MashedPotato817/CargoTracker-STM32H7/pic/5 loT系统前后端交互架构图.png

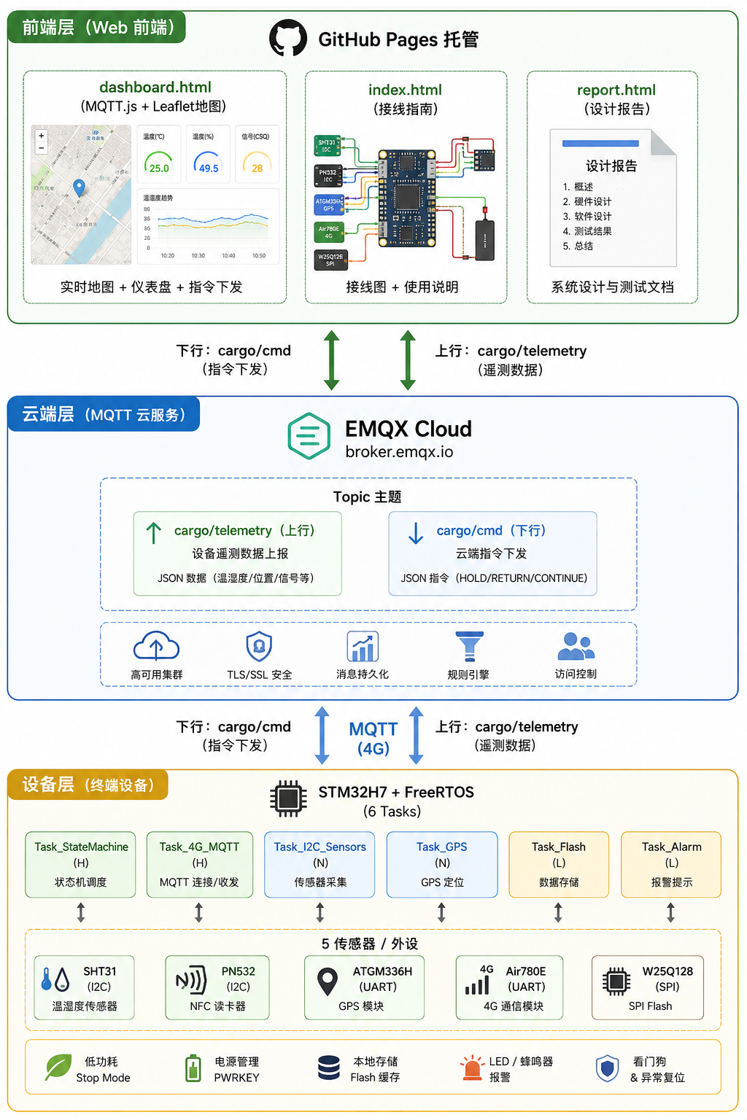
pic/5 loT系统前后端交互架构图.png
