MashedPotato817/CargoTracker-STM32H7/pic/硬件总览图.png

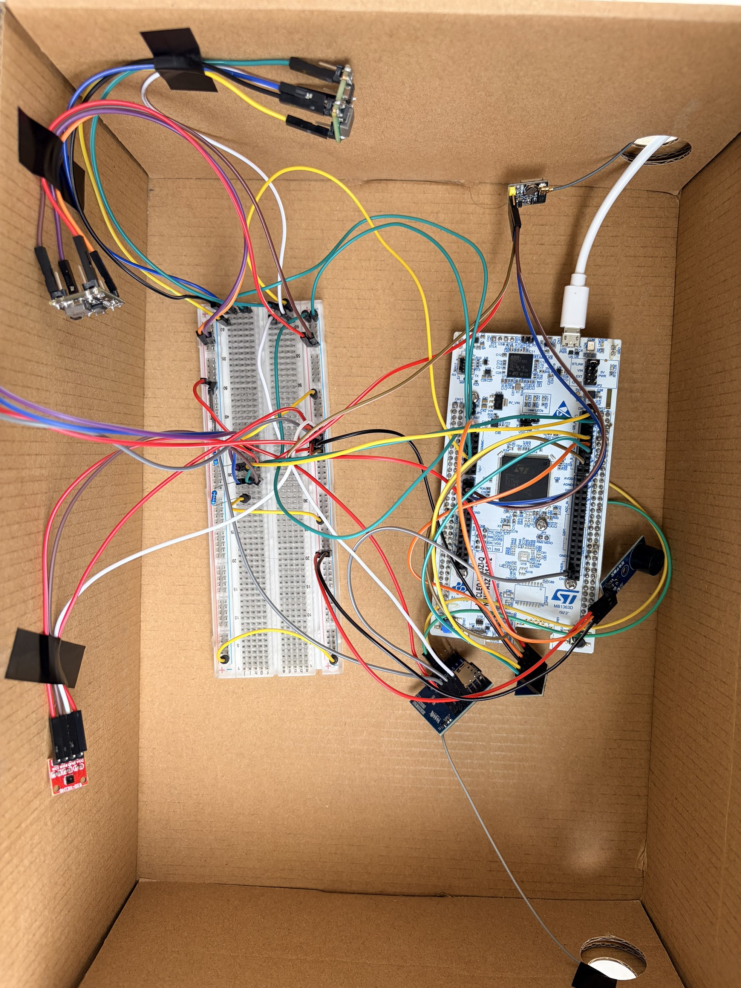
pic/硬件总览图.png
