MashedPotato817/CargoTracker-STM32H7/report-workflow/video-script.md

# 演示视频解说文案

> 匿名要求：不出现学校名称、logo、校徽、导师信息
> 时长：严格控制在 3 分钟内

---

## 分段文案

### 片头（0:00-0:02）
> 大赛统一封面，不添加任何字幕或文字

---

### 第 1 段：作品介绍（0:02-0:18）

| 画面 | 字幕 | 配音 |
|---|---|---|
| 整机接线正面特写 → 45° 斜拍全景，所有模块清晰可见 | 基于 STM32H7 的智能货物追踪物联网系统 | 本作品是一款基于 STM32H7 的智能货物追踪设备，集成了 GPS 定位、NFC 激活、温湿度监测、4G 云端通信和低功耗管理。 |

---

### 第 2 段：NFC 激活演示（0:18-0:38）

| 画面 | 字幕 | 配音 |
|---|---|---|
| 设备处于休眠状态，黄色 LED 慢闪 → NFC 标签靠近 PN532 → LED 状态变化 → 设备被唤醒 | NFC 无源激活 | 设备上电后默认处于深度睡眠模式。使用 NTAG215 NFC 标签靠近 PN532 读卡模块，设备被瞬间唤醒，进入工作循环。 |
| 串口打印 `[NFC] activation event` | 串口实时输出 | 整个过程无需物理按键，实现无源、无接触激活。 |

---

### 第 3 段：GPS 定位（0:38-1:05）

| 画面 | 字幕 | 配音 |
|---|---|---|
| 画中画——主画面：GPS 模块特写（蓝色 LED 闪烁） / 小窗：dashboard 地图 marker 从默认华东视角飞行到设备位置 | GPS 实时定位 | 设备唤醒后，ATGM336H GPS 模块开始搜星定位。通过 USART2 接收 NMEA 语句，解析 RMC 和 GGA 帧，提取 WGS-84 经纬度坐标。 |
| dashboard 地图 zoom in 到设备位置，经纬度数字显示 | 坐标实时上报 | 定位数据通过 4G 网络上传至云端，配套 Web 控制台使用 Leaflet 地图实时标记设备位置。 |

---

### 第 4 段：温湿度监测（1:05-1:30）

| 画面 | 字幕 | 配音 |
|---|---|---|
| SHT31 传感器特写 → 手指靠近传感器 | SHT31 温湿度采集 | SHT31 高精度温湿度传感器，通过 I2C 总线读取数据，含 CRC8 校验确保数据完整性。 |
| 串口输出温度从 25°C 升至 27°C → dashboard 仪表盘温度数字同步上升 | 温度 25°C → 27°C | 手指靠近传感器，温度即刻响应。采样采用请求-响应模式，状态机置位采样标志，传感器任务仅在需要时读取，避免周期性无效采样，降低系统功耗。 |

---

### 第 5 段：4G 上报 + 云端控制台（1:30-2:00）

| 画面 | 字幕 | 配音 |
|---|---|---|
| Air780E 4G 模块特写（天线+指示灯）→ dashboard 仪表盘全貌（温湿度仪表+地图+信号强度+数据日志） | 4G MQTT 云端上报 | Air780E 4G 模块通过 AT 指令建立 TCP 连接，使用自研二进制 MQTT 协议栈完成 CONNECT、PUBLISH、SUBSCRIBE 帧构建。 |
| dashboard 数据日志滚动，显示 JSON 数据 | 每 10 秒上报一次 | 温湿度、GPS 坐标、4G 信号强度封装为 JSON，每 10 秒通过 MQTT 发布至 EMQX Broker，配套自建 Web 控制台实时接收并可视化展示。 |
| 手机端打开 dashboard，展示移动端适配效果 | 手机扫码即可查看 | 控制台为单文件 HTML，托管于 GitHub Pages，手机扫码即可实时查看货物状态。 |

---

### 第 6 段：云端指令（2:00-2:25）

| 画面 | 字幕 | 配音 |
|---|---|---|
| 画中画——主画面：dashboard 点击「暂留」按钮 / 小窗：设备 LED 变化（黄色常亮） | 云端指令：暂留 | 云端控制台支持三指令下发——暂留、退货、继续运输。点击「暂留」，设备收到指令后黄色 LED 常亮，保持唤醒等待后续指令。 |
| 点击「退货」→ 蜂鸣器鸣叫 + LED 快闪 | 退货：触发报警 | 点击「退货」，设备触发声光报警——蜂鸣器鸣叫，LED 快闪。 |
| 点击「继续运输」→ 恢复正常心跳闪烁 | 继续运输：恢复正常 | 点击「继续运输」，清除报警状态，LED 恢复心跳闪烁，货物继续运输。 |

---

### 第 7 段：低功耗休眠（2:25-2:45）

| 画面 | 字幕 | 配音 |
|---|---|---|
| 指令执行完毕后 → 串口打印进入 Stop Mode → 设备静默 | 低功耗 Stop Mode | 任务完成后，设备通过 PWRKEY 关闭 4G 模块，MCU 进入 STOP 低功耗模式，电流降至微安级。 |
| NFC 标签再次靠近 → 设备再次唤醒 | NFC 再次唤醒 | 再次使用 NFC 标签靠近，设备被重新唤醒，进入下一个工作循环。实现全流程自动化闭环。 |

---

### 第 8 段：全链路回顾（2:45-2:55）

| 画面 | 字幕 | 配音 |
|---|---|---|
| 快速混剪：NFC 刷卡 → GPS 坐标更新 → 温度变化 → dashboard 仪表盘刷新 → 指令下发 → LED 响应 → 休眠 | NFC → GPS → SHT31 → MQTT → 云指令 → 休眠 | 从 NFC 激活到云端指令响应，整条链路全自动化——无接触唤醒，实时定位，环境监测，4G 上报，远程控制，智能休眠。 |

---

### 结尾（2:55-3:00）

| 画面 | 字幕 |
|---|---|
| 黑底白字 | 谢谢观看 |

> 结尾不出现学校名称、队名、队员姓名。

---

## 注意事项

- 所有字幕和配音**不包含学校名称/logo/校徽/导师信息**
- GPS 定位等待片段可 1.5x 加速，但不能跳过
- 蜂鸣器报警声**务必录进去**——证明硬件真正在工作
- 串口输出画面保留 1-2 秒以便评委看清
- 双画面画中画用于第 3 段（GPS+地图）和第 6 段（指令+LED），强调软硬件协同
