MashedPotato817/CargoTracker-STM32H7/doc-workflow/last-tasks.md

# 未完成任务清单

> 截止：**2026-07-09 18:00** | 由 task2/3/4/5 + code-review 汇总生成
>
> 状态：✅ 完成 ⚠️ 部分完成/阻塞 ❌ 未开始

---

## 一、硬件验证（task2 遗留）

| # | 任务 | 负责人 | 状态 | 阻塞原因 |
|:---:|---|:---:|:---:|---|
| 2.2 | PN532 NFC 标签读取验证 | A | ⚠️ | init OK，未测试实际标签 |
| 2.3 | GPS 户外真坐标测试 | B | ⚠️ | 当前 stub 31/121，需户外 |
| 2.4 | W25Q128 读写验证 | A | ⚠️ | JEDEC OK，读写未测 |
| 2.7 | 系统集成测试（9 项） | C | ❌ | 依赖 2.2-2.6 全部完成 |

---

## 二、云端功能（task3 遗留）

| # | 任务 | 负责人 | 状态 | 说明 |
|:---:|---|:---:|:---:|---|
| 3.3 | 云指令端到端验证 | B+C | ⚠️ | 代码已就绪，待硬件联调 |
| 3.4 | 断网缓存补传 | B | ❌ | 依赖 W25Q128 读写验证 + code-review #5,#6 |

### code-review 阻塞项（影响 3.4）

| 编号 | 问题 | 负责人 |
|:---:|---|:---:|
| #5 | W25Q128 重启擦除扇区 — 缓存数据不可逆销毁 | A |
| #6 | W25Q128 读取/上传路径完全缺失 | A |

> 修复后 3.4 才能推进。

---

## 三、低功耗优化（task4 全部）

| # | 任务 | 负责人 | 状态 | 预计 |
|:---:|---|:---:|:---:|:---:|
| 4.1 | Stop Mode 实现（替换 stub） | C | ❌ | 1h |
| 4.2 | 功耗测量（全速 + Stop） | C | ❌ | 0.5h |
| 4.3 | 4G 空闲断电 | C | ❌ | 1h |
| 4.4 | 电池续航估算 | C | ❌ | 0.5h |

> code-review #6 正是 Stop Mode stub 问题，已确认是全速空转。论文需要本章数据。

---

## 四、产出物（task5）

| # | 产出 | 负责人 | 状态 | 说明 |
|:---:|---|:---:|:---:|---|
| 5.3 | 报告 PDF | C | ⚠️ | 内容已有，缺实物照片 + 打印样式 |
| 5.4 | 演示视频 MP4 | 全员 | ❌ | 需硬件跑通后拍摄 |
| 5.5 | 代码 RAR | C | ❌ | 0.5h，最后打包 |

---

## 五、code-review P0/P1 未修复项

| 优先级 | 编号 | 问题 | 负责人 | 状态 |
|:---:|:---:|---|:---:|:---:|
| P0 | #1,#2 | USART1 互斥锁 + DMA/中断接收 | B | ❌ |
| P0 | #3 | TCP_SendBinary 验证 SEND OK | B | ✅ 已修 |
| P0 | #4 | CONNACK 返回码检查 | B | ❌ |
| P0 | - | CSQ 加入 telemetry | B | ✅ 已修 (16d426d) |
| P1 | #5,#6 | W25Q128 重启不擦除 + 补上传路径 | A | ❌ |
| P1 | #7 | printf 加互斥锁 | C | ❌ |
| P1 | #8 | HAL_Delay → osDelay 全局替换（5 处） | A/B/C | ❌ |

---

## 六、按负责人的行动清单

### A（驱动层）
- [ ] PN532 标签读取测试（2.2）
- [ ] W25Q128 读写验证（2.4）
- [ ] **W25Q128 重启不擦除 + 补读取/上传路径**（review #5,#6）
- [ ] PN532 DCS 校验 + 缓冲区越界修复（review #10,#11）
- [ ] W25Q128 WEL 校验（review #12）
- [ ] sht31/pn532 HAL_Delay → osDelay（review #8）

### B（通信层）
- [x] **CSQ 加入 telemetry** ✅ (16d426d)
- [x] PDP 激活 + 上报周期优化 ✅ (16d426d)
- [ ] GPS 户外真坐标测试（2.3）
- [ ] **USART1 DMA/中断接收 + 互斥锁**（review #1,#2）— 最重要
- [ ] CONNACK 返回码检查（review #4）
- [ ] MQTT 命令误触发修复（review #15）
- [ ] GPS 空字段校验 + strtok_r + 精度（review #13,#14,#18）
- [ ] AT 命令重试 + 掉线恢复（review #17,#19）
- [ ] mqtt HAL_Delay → osDelay（review #8）

### C（应用层 + 前端 + 文档）

**✅ 已完成：**
- [x] dashboard 自动重连 + 地图定位 + 移动端修复
- [x] 三页面统一 footer 跳转
- [x] 代码全面审查报告 (29 问题)
- [x] task5 产出物对齐 demand.md
- [x] doc-workflow 目录整理

**❌ C 代码阻塞（队友在改，不碰）：**
- [ ] printf 互斥锁、HAL_Delay→osDelay、Stop Mode、死代码

**📋 可做：**
- [ ] 报告 print 样式 → 导出 PDF（task 5.3）— 缺实物照片
- [ ] 代码 RAR 打包（task 5.5）
- [ ] 视频（task 5.4）— 等硬件

---

## 七、建议执行顺序

```
1. C: printf 互斥锁 (15min)                   ← 快速修复，所有人受益
2. C: power.c HAL_Delay → osDelay (10min)      ← 解除 6.5s 阻塞
3. B: USART1 DMA/中断 + 互斥锁 (3-4h)          ← 最关键通信修复
4. A: W25Q128 修复 (3-4h)                       ← 断网缓存能真正工作
5. A+B: 各自 HAL_Delay → osDelay                ← 5 处全局替换
6. C: Stop Mode 实现 (1h)                       ← 论文数据 + 低功耗
7. C: 功耗测量 (0.5h)                            ← 论文必须
8. 全员: 系统联调 + 视频拍摄                     ← 产出物
9. C: 报告导出 + 代码打包                        ← 提交
```

---

> 参考：`doc/code-review-20260709.md` | 生成时间：2026-07-09
