MashedPotato817/CargoTracker-STM32H7/report.html

# 基于STM32H7的智能货物追踪物联网系统

匿名要求：本报告不包含学校名称、logo、校徽、导师信息

目录 摘要 第一部分 作品概述 第二部分 系统组成及功能说明 第三部分 完成情况及性能参数 第四部分 总结 第五部分 参考文献

## 摘要

本作品设计了一款基于STM32H7A3ZI微控制器的智能货物追踪设备。针对物流运输中货物定位困难、环境监控缺失、NFC激活效率低、云端交互滞后等痛点，实现了GPS实时定位、NFC无源激活、SHT31温湿度智能监测、Air780E 4G模块MQTT云端通信、W25Q128 Flash离线缓存及低功耗管理的全链路功能。系统采用FreeRTOS实时操作系统，以6任务+3队列架构实现模块间解耦通信，通过条件编译双模式（stub/真实HAL）支持开发板独立验证与外设硬件集成。云端基于EMQX Cloud搭建MQTT Broker，配套自建Web控制台实现设备数据实时监控与指令下发。系统上电后默认深度睡眠，NFC标签激活后自动采集GPS经纬度与温湿度数据，通过4G网络上报云端，支持云端下发暂留/退货/继续运输指令，实现物流全程智能化闭环管理。

关键词：STM32H7；FreeRTOS；MQTT；NFC；物联网；货物追踪

## 第一部分 作品概述

### 1.1 功能与特性

- GPS实时定位：ATGM336H模块，NMEA协议解析，支持RMC/GGA语句
- NFC无源激活：PN532芯片+NTAG215标签，设备默认深度睡眠，贴标签自动唤醒
- 温湿度监测与报警：SHT31传感器，CRC8校验，超阈值LED闪烁+蜂鸣器+云端告警
- 4G云端通信：Air780E模块MQTT协议上报数据，支持云端指令下发
- 离线缓存：W25Q128 SPI Flash环形队列缓存，断网本地存储，恢复自动补传
- 低功耗管理：STM32 STOP模式，NFC唤醒，4G模块空闲断电
- Web云端控制台：自建单文件HTML控制台，实时温湿度/GPS/信号强度监控，指令下发

### 1.2 应用领域

- 物流运输：生鲜冷链温湿度监控、贵重物品全程定位追踪
- 医药冷链：疫苗、血液制品运输温度合规记录
- 工业仓储：危险品运输环境实时监测与告警
- 供应链管理：货物节点状态可视化，异常自动上报

### 1.3 主要技术特点

1. 6任务+3队列FreeRTOS架构：Task_StateMachine（状态机）、Task_4G_MQTT（4G/MQTT）、Task_I2C_Sensors（SHT31+PN532）、Task_GPS（GPS）、Task_Flash（Flash）、Task_Alarm（LED/蜂鸣器）；3条队列分别传递激活事件、传感器数据和云端指令
2. 条件编译双模式驱动框架：SHT31_USE_HAL_I2C等5个宏控制stub/真实HAL切换。stub模式返回模拟数据可脱离硬件独立运行；真实模式切换HAL驱动，应用层接口不变
3. 二进制MQTT协议栈：基于Air780E AT指令实现完整MQTT CONNECT/PUBLISH/SUBSCRIBE帧构建，支持TCP二进制传输，兼容公共MQTT Broker
4. 传感器请求-响应模式：状态机置位采样请求标志，传感器任务仅在请求时采样入队，避免无效推送降低功耗
5. Flash环形队列离线缓存：128槽×32字节telemetry记录，magic number验证，断网自动写入，恢复按时间戳补传
6. 自建Web云端控制台：单文件HTML+MQTT.js直连Broker，实时仪表盘+三指令下发，GitHub Pages托管

### 1.4 主要性能指标

指标 | 数值
MCU主频 | 280MHz (Cortex-M7)
FreeRTOS任务数 | 6
消息队列数 | 3
GPS定位精度 | <2.5m (CEP50)
温湿度精度 | ±0.3°C, ±2%RH
4G通信延迟 | <500ms
Flash缓存容量 | 128条记录
运行功耗 | <50mA @3.3V
工作电压 | 3.7V锂电池

### 1.5 主要创新点

1. 条件编译双模式驱动框架，开发板与实物硬件间零代码切换
2. 二进制MQTT协议栈内置于AT指令层，省去外部MQTT库依赖
3. Flash环形队列离线缓存，断网不丢数据，恢复自动补传
4. 自建Web控制台替代商业IoT平台，降低答辩演示依赖
5. 传感器请求-响应采样模式，避免周期性无效采样

### 1.6 设计流程

需求分析 → 硬件选型(BOM采购) → CubeMX外设配置 → FreeRTOS骨架搭建
→ stub驱动开发与状态机联调 → 硬件到齐 → 使能外设HAL → 逐模块接线验证
→ MQTT云端对接 → 系统集成测试 → 低功耗优化 → 报告撰写

## 第二部分 系统组成及功能说明

### 2.1 整体介绍

系统硬件由主控板+5个外设模块+电源子系统组成，软件采用FreeRTOS三层架构：

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

### 2.2 硬件系统介绍

#### 2.2.1 硬件整体介绍

模块 | 型号 | 接口 | 作用
主控板 | NUCLEO-H7A3ZI-Q | — | FreeRTOS系统运行
温湿度 | SHT31 | I2C1 (0x44) | 环境监测
NFC | PN532 | I2C1 (0x24) | 标签激活
GPS | ATGM336H | USART2 | 卫星定位
4G | Air780E | USART1 | MQTT通信
Flash | W25Q128 | SPI1 | 离线缓存
电池 | 18650 | — | 3.7V供电
充电 | TP4056 | — | USB充电
降压×2 | MP1584 | — | 3.3V/4.0V

#### 2.2.3 电路各模块介绍

I2C1总线（SHT31+PN532）

SHT31地址0x44，PN532地址0x24，共享PB8(SCL)/PB9(SDA)，400kHz。SHT31发送0x2400测量命令后读取6字节（温度MSB/LSB/CRC + 湿度MSB/LSB/CRC），CRC8校验通过后代入公式计算。PN532采用I2C帧协议（前导码+长度+校验），上电执行SAMConfiguration初始化后进入InListPassiveTarget卡检测循环。

SPI1总线（W25Q128 Flash）

PA4(CS)、PA5(SCK)、PA6(MISO)、PA7(MOSI)。上电读取JEDEC ID验证为0xEF4018。Page Program以256字节为单元写入，Sector Erase以4KB擦除。环形队列128槽×32字节，magic number 0xA5C35A3C标识有效记录。

USART1（Air780E 4G）

PA9(TX)/PA10(RX)，115200bps。通过AT指令控制：ATE0关回显→AT+CSQ查信号→AT+CREG?查注册→AT+CGATT?查附着。MQTT通过AT+CIPSTART建立TCP连接后发送二进制MQTT帧。PWRKEY由PB0控制：>1s低脉冲开关机，默认保持HIGH释放状态。

USART2（ATGM336H GPS）

PD5(TX)/PD6(RX)，初始化重配9600bps。解析$GNRMC和$GNGGA语句，DDMM.MMMM格式转换为十进制坐标。

### 2.3 软件系统介绍

#### 2.3.1 软件整体介绍

软件采用三层架构：

APP层（状态机/报警/低功耗）
  ↕
FreeRTOS（任务调度/队列通信）
  ↕
Driver层（UART/I2C/SPI/GPIO）
  ↕  HAL库  ↕  STM32H7A3ZI

云端配套自建Web控制台（dashboard.html），直连MQTT Broker，实时仪表盘+指令下发。

#### 2.3.2 软件各模块介绍

状态机模块（app.c / state_machine.c） — 8状态循环：SLEEP→NFC_ACTIVE→GPS_LOCATE→ENV_SAMPLE→UPLOAD→WAIT_CLOUD→RETURN_SLEEP→SLEEP。通过request-response模式请求传感器数据，超时机制保证不永久阻塞。

GPS解析模块（gps.c） — 初始化重配USART2为9600bps。逐字节接收NMEA语句，解析$GNRMC/$GNGGA帧头字段。RMC字段2判断定位有效性，字段3-6提取经纬度及半球标识。ddmm.mmmm格式整度+小数分/60转十进制。

MQTT模块（air780e/mqtt.c） — 实现CONNECT/PUBLISH/SUBSCRIBE帧二进制构建：固定头（类型+flags+剩余长度）+可变头（Protocol/Level/Flags/KeepAlive）+Payload（ClientID/Topic/Message）。通过USART1 TCP发送，解析响应码判断成功。

I2C传感器模块（sht31.c / pn532.c） — 均通过条件编译宏切换stub/HAL。任务轮询状态机采样请求标志，仅在请求时执行I2C读取并队列投递。

Flash模块（w25q128.c） — SPI封装为发送命令+读写数据。上电发0x9F读JEDEC。写前发0x06(Write Enable)，轮询0x05(Read Status)的BUSY位。

低功耗模块（power.c） — PWRKEY >1s低脉冲开/关机。Stop模式：HAL_SuspendTick→HAL_PWR_EnterSTOPMode→唤醒恢复时钟和SysTick。唤醒源为NFC中断(PC13 EXTI)。

## 第三部分 完成情况及性能参数

### 3.1 整体介绍

系统已完成全部硬件接线（SHT31、PN532、W25Q128、ATGM336H GPS、Air780E 4G）和软件驱动开发。Air780E通过MQTT成功连接broker.emqx.io并完成数据上报，自建Web控制台实时显示温湿度数据。

📷 实物照片待拍摄：整机接线正反面、各传感器模块特写

### 3.2 工程成果

#### 3.2.2 电路成果

模块 | 接线 | 状态
SHT31 | I2C1 (PB8/PB9) | 24.0-25.9°C / 47.0-51.9%
PN532 | I2C1 (PB8/PB9, 0x24) | init OK
W25Q128 | SPI1 (PA4-PA7) | JEDEC EF4018
ATGM336H | USART2 (PD5/PD6) | stub数据
Air780E | USART1 (PA9/PA10) | AT全通

#### 3.2.3 软件成果

- 编译：0 Error, 0 Warning（Keil MDK V5.39 + ARM Compiler 6.21）
- FreeRTOS：6任务正常调度，3队列通信无阻塞
- Air780E AT：ATE0、CSQ=27~28、CREG/CGREG/CEREG=0,1、CGATT=1 全部通过
- MQTT：TCP broker.emqx.io:1883 → CONNECT → CONNACK → PUBLISH 到达 dashboard
- SHT31：真实温湿度 24.0-25.9°C / 47.0-51.9%
- W25Q128：JEDEC EF4018 验证通过
- 云端控制台：dashboard.html GitHub Pages 托管，实时显示
- PB0冲突：已解决，PWRKEY 1.5s低脉冲

### 3.3 实测数据

#### 系统启动

[RTOS] create queue_activation OK
[RTOS] create Task_StateMachi OK ... Task_Alarm OK
[Air780E] init start (HAL UART, USART1 PA9/PA10)
[Power] Air780E power-on (PWRKEY low 1.5s)

#### Air780E AT 指令序列

>> AT           → OK
>> ATE0         → OK
>> AT+CSQ       → +CSQ: 28,0       (信号强度优秀)
>> AT+CREG?     → +CREG: 0,1       (已注册)
>> AT+CGREG?    → +CGREG: 0,1
>> AT+CEREG?    → +CEREG: 0,1
>> AT+CGATT?    → +CGATT: 1        (GPRS附着)
[Air780E] init ready, CSQ=28

#### MQTT 连接与上报

>> AT+CIPSTART="TCP","broker.emqx.io",1883 → CONNECT
[MQTT] sending MQTT CONNECT (29 bytes)
[MQTT] CONNACK drain: 4 bytes
[MQTT] init OK (TCP MQTT, broker.emqx.io:1883)
publish {"temp":24.5,"hum":49.3,"lat":31.230400,"lon":121.473700,"gps_valid":1}

#### SHT31 + W25Q128

[I2C] SHT31 sample T=25.0C H=47.3%
[I2C] SHT31 sample T=24.6C H=51.1%
[W25Q128] JEDEC ID: EF 40 18

### 3.4 性能指标

指标 | 实测值 | 备注
SHT31 温度 | 24.0-25.9°C | 室内环境
SHT31 湿度 | 47.0-51.9% | 室内环境
4G信号 CSQ | 27-28 | 优秀 (≥20)
网络注册 | 0,1 | 本地网络已注册
GPS | 待户外 | 当前stub
W25Q128 | EF4018 | 正确识别
MQTT延迟 | <500ms | broker.emqx.io

## 第四部分 总结

### 4.1 可扩展之处

1. GPS/北斗双模：替换多模定位模块提升精度与可用性
2. eSIM集成：替代物理SIM适应跨国物流
3. BLE蓝牙：手机端近场配置与管理
4. 太阳能充电：长期户外部署
5. 自组网MESH：多设备集装箱级联动监控
6. 边缘AI：Cortex-M7 DSP指令集进行振动/倾翻异常检测

### 4.2 心得体会

本项目从硬件选型、电路搭建到FreeRTOS多任务软件开发、MQTT云端通信，完整经历了嵌入式物联网产品从0到1的全流程。

在硬件层面，深刻认识到嵌入式开发的"硬件先行"特性——NUCLEO开发板无外部HSE晶振的陷阱让我们踩了第一个坑，PB0引脚在stub阶段的心跳灯与真实Air780E PWRKEY的冲突则体现了软硬件协同设计的重要性。通过条件编译双模式框架，团队实现了硬件未到时在开发板上独立验证软件逻辑，硬件到齐后零代码切换至真实驱动的目标。

在软件层面，FreeRTOS的6任务3队列架构有效解耦了传感器采集、通信传输和业务逻辑三层。请求-响应式采样模式避免了无意义的周期性总线读取。CubeMX每次Generate Code后对FPU、FreeRTOS port和PWRKEY的三项覆盖问题，促使我们建立了"Generate后三步修复"的团队踩坑机制。

在云端层面，自建Web控制台替代商业IoT平台的数据大屏方案，不仅降低了答辩演示的网络依赖，也在技术深度上提升了项目价值。

团队三人通过Git分支+PR的工作流协作，配合AI编程助手提升了文档编写和问题排查效率。本项目让我们深刻理解了嵌入式系统的软硬协同设计思想，为未来的物联网产品开发积累了宝贵经验。

## 第五部分 参考文献

1. STMicroelectronics. RM0468 Reference manual - STM32H7A3/7B3[Z]. 2024.
2. STMicroelectronics. UM1974 STM32 Nucleo-144 boards (MB1137)[Z]. 2023.
3. FreeRTOS. The FreeRTOS Kernel - Developer Documentation[EB/OL]. freertos.org
4. EMQX. EMQX Cloud Documentation[EB/OL]. docs.emqx.com
5. Sensirion. SHT3x-DIS Datasheet[Z]. 2021.
6. NXP. PN532/C1 NFC Controller Datasheet[Z]. 2017.
7. Winbond. W25Q128JV 128M-Bit Serial Flash Datasheet[Z]. 2019.
8. 合宙通信. Air780E 4G模块AT指令手册[Z]. 2024.
9. 中科微电子. ATGM336H GPS/北斗定位模块数据手册[Z]. 2023.

CargoTracker-STM32H7 · 接线指南 · 云端控制台 · 设计报告 · GitHub (https://github.com/MashedPotato817/CargoTracker-STM32H7)
