MashedPotato817/CargoTracker-STM32H7/report-workflow/suggest.md

在嵌入式与电子设计类竞赛（如**全国大学生电子设计竞赛（国奖/电赛）**、**中国研究生创芯大赛**、**蓝桥杯嵌入式**、**大创**等）中，一份优秀的**作品设计报告**是决定能否拿奖（尤其是国奖答辩资格）的关键。

这类报告与普通的期末大作业或纯软件开发文档不同，它极其注重**软硬件结合的系统性、测试数据的严密性以及格式的规范性**。以下为你整理的嵌入式比赛报告核心要求与标准结构：

---

## 一、 严苛的“高压线”与基本格式要求

在准备报告前，必须绝对遵守以下规范，否则可能直接面临**一票否决（取消评审资格）**：

* **匿名原则（盲审）**：正文、图表、页眉页脚、甚至是代码片段中，**绝对不能出现**学校名称、队伍编号、队员及指导老师姓名。
* **字数与篇幅限制**：以电赛（NUEDC）为例，正文长度通常严格限制在 **A4纸 8 页以内**（含图表，不含附录代码），首页通常要求附 **300字以内的中文摘要**。
* **排版规范**：通常要求正文小四号宋体/新罗马字体，固定行距（如22磅），且上方要留出足够的空白（通常为3cm以上）用于赛区统一装订和密封。

---

## 二、 报告的标准结构与核心内容

一份标准的嵌入式比赛报告，通常由以下六大核心板块构成：

### 1. 摘要与关键词（Abstract）

* **内容**：用精炼的语言说清：**“本系统实现了什么功能 + 采用了什么核心芯片/算法 + 达到了什么指标”**。
* **要点**：摘要中必须包含**具体的量化测试结果**（例如：“纹波效率达到95%”、“响应时间小于10ms”），切忌假大空。

### 2. 系统方案论证（最体现水平的板块）

评委非常看重你为什么选择这个方案，而不是那个方案。需要对关键模块进行**对比论证**：

* **主控芯片选择**：例如，为什么用 STM32 还是 FPGA？（从算力、外设、功耗、成本等维度对比，可用表格呈现）。
* **传感器/驱动模块选择**：对比不同型号传感器的精度、通信接口（I2C/SPI/串口）。
* **软件架构/算法论证**：是采用裸机状态机，还是 FreeRTOS 实时操作系统？PID控制还是模糊控制？

### 3. 硬件电路设计（图表要清晰）

* **系统整体框图**：给出清晰的硬件架构拓扑图，明确电源流向和信号流向。
* **核心模块电路**：
* **电源模块**：嵌入式系统的基石（如 5V 转 3.3V，LDO 还是 DC-DC 降压）。
* **信号调理/驱动电路**：如放大电路、光耦隔离、电机驱动（H桥）电路。
* **注意**：报告中放入的原理图切忌直接从 Altium Designer 里截个大模糊图，应转成清晰的矢量图或单色精简原理图，并对关键元件参数（如滤波电容、上拉电阻）做简要计算说明。

### 4. 软件设计与算法实现（体现逻辑）

* **程序流程图**：必须包含**主程序流程图**和**核心中断/算法流程图**。
* **功能模块划分**：阐述各个任务（Task）的分配与优先级，如何进行低功耗管理或数据缓存。
* **核心算法描述**：如果涉及滤波算法（如卡尔曼滤波）、控制算法（如增量式PID）或路径规划，需给出数学公式和离散化实现思路。

### 5. 测试方案与测试结果（决定成败的硬指标）

评委往往最先翻到这一页看指标是否达标。

* **测试仪器**：列出测试使用的标准仪器（如：数字示波器、万用表、可编程电子负载）。
* **测试方法**：用图示或文字说清楚你怎么测的（例如：在哪里接的探头，如何模拟负载）。
* **测试数据（重中之重）**：
* 严禁只有一两组数据，必须有**多组测试数据表格**。
* 必须绘制**误差分析曲线或对比图表**。

* **结果分析**：根据数据得出结论，客观说明是否达到题目要求的发挥部分指标，若有误差，分析其产生原因（如线阻、ADC采样噪声等）。

### 6. 附录（Appendix）

* 主要放置**核心代码片段**（如初始化、核心控制算法，千万别把整个工程几千行代码全粘上去）。
* 部分比赛允许附上元器件清单（BOM表）。

---

## 三、 网上评委/学长推荐的拿奖加分项

1. **善用图表，拒绝大段文字**：能用表格对比的就不用文字，能用流程图、时序图、结构图解释的就不要写长篇大论。评委阅卷时间极短，**视觉可读性**决定第一印象。
2. **软硬件并重**：很多偏硬件的队伍软件写得很简陋，或者偏软件的队伍硬件电路全是买的模块。报告中如果能体现出**自己画的PCB Layout板图、3D效果图**，以及**软件架构的严密性**，会大大加分。
3. **理论计算与实际测试呼应**：在硬件设计里推导了某个滤波器的截止频率公式，在测试结果里最好能用示波器波形图来验证这个点。**理论 $\rightarrow$ 仿真 $\rightarrow$ 实测**的闭环是特等奖作品的标配。

你目前是在为某项具体的嵌入式比赛（如电赛、蓝桥杯、或某个大创项目）做准备吗？如果是，可以告诉我具体的比赛名称或选题方向，我可以为你提供更具针对性的排版模板或往届获奖报告的侧重点建议。
