MashedPotato817/CargoTracker-STM32H7/report-workflow/demand.md

# 附件1：全国大学生嵌入式芯片与系统设计竞赛
## 2026年应用赛道作品上传要求

作品上传要求如下：

### 1、作品介绍视频
-   **格式要求**：MP4格式
-   **时长限制**：总时长3分钟以内（其中大赛统一封面时长不超过2秒），请严格控制时间
-   **大小限制**：文件控制300M内
-   **内容提示**：切忌全部为ppt讲解过程，请把重点放在作品演示上

### 2、作品设计报告
-   **格式要求**：PDF格式
-   **大小限制**：50M以内

### 3、作品重要代码
-   **格式要求**：RAR压缩包
-   **大小限制**：100M以内

### 4、报名信息修改
-   作品名称及简介信息修改申请权限计划于2026年6月8日开放
-   所有报名信息（包括团队成员及作品信息）修改均于6月30日24时截止

### 5、作品上传截止
-   作品提交计划于2026年7月9日18时截止

### 6、匿名要求
-   作品报告及视频中均不可出现学校名称及指导老师信息等字样
-   ⚠️ **违规后果**：如有违反则取消参赛资格

---

## 💡 温馨提示

-   🔍 **提交截止时间**：7月9日18时，越到最后越拥堵，请提前提交
-   ⚙️ **避免学校信息**：名称、logo、校徽、地图位置等均不可出现
-   📊 **作品视频片头**：请使用大赛提供的作品图片片头
