MashedPotato817/CargoTracker-STM32H7/doc-workflow/task3.md

# Task 3: 云平台对接

> 可与 Task 2 硬件验证并行。优先级标记：🔴必做 🟡加分 🟢可选

## 前置条件

- [x] Air780E 4G 模块已采购
- [ ] Air780E AT 验证通过（Task 2.5）
- [ ] PB0 已解决（Task 2.6）

---

## 🔴 Task 3.1: 云平台注册

**负责人：任意（无需硬件）** | 预计：1h

| 平台 | 免费额度 | 推荐理由 |
|---|---|---|
| 阿里云 IoT | 100 设备/月 | 毕设/竞赛首选，Web 控制台截图好看 |
| EMQX Cloud | 1M 消息/月 | 最简单，标准 MQTT，5 分钟搞定 |

操作：注册 → 创建产品 → 创建设备 → 拿到三元组 → 记下 broker 地址。

---

## 🔴 Task 3.2: 数据上报验证（最小闭环）

**负责人：B** | 依赖：Task 2.5 + 3.1 | 预计：2h

只做最核心的一步：设备上电 → MQTT 连接 → 发布一条温湿度 JSON → 云端看到数据。

```json
{"ts":1718123456,"temp":25.5,"hum":60.0,"lat":31.23,"lon":121.47}
```

串口看到 `+CMQTTPUB: 0,0` 且云端控制台显示数据 = 核心功能打通。

---

## 🟡 Task 3.3: 云指令下发

**负责人：B + C** | 预计：2h

设备订阅下行 Topic，云端发 HOLD/RETURN/CONTINUE → 设备收到并打印。

> 加分项：答辩演示时远端控制设备，效果突出。但最小闭环（3.2）即可答辩。

---

## 🟢 Task 3.4: 断网缓存补传

**负责人：B** | 预计：2h | 状态：❌ 未开始

拔 4G 天线 → 发布失败 → W25Q128 写入 → 插回天线 → 自动补传。

> 依赖 W25Q128 读写验证（Task 2.4 未完成）+ 系统集成测试（Task 2.7）。
> 锦上添花。答辩时如果时间紧可说"已设计，待验证"。

---

## 🟡 Task 3.5: 地图实时定位显示

**负责人：C** | 预计：1h | 状态：✅ 页面显示已完成，⚠️ marker 跟随待真实 GPS 验证

dashboard.html 嵌入 Leaflet 地图，根据 GPS 经纬度实时显示设备位置。已修复实际页面中地图瓦片右侧/底部未铺满的问题，当前截图验证地图可完整显示长三角区域。

详见 `doc-workflow/task3.5.md`。
