MashedPotato817/CargoTracker-STM32H7/doc-workflow/task5.md

# Task 5: 整机测试 + 产出物

> 🔴必做 🟡加分 🟢可选
> 截止：**2026-07-09 18:00**
> 匿名：报告和视频**禁止**出现学校名称、logo、校徽、指导老师

---

## Part A: 系统测试

### 🔴 Task 5.1: 核心功能验证

**负责人：全员** | 预计：2h

只测答辩必须展示的：

| # | 测试 | 通过标准 |
|---|---|---|
| 1 | NFC 激活 | 贴标签 → LED 变化 |
| 2 | GPS 定位 | 户外 3min 内拿到有效坐标 |
| 3 | 温湿度 | 串口读数合理 |
| 4 | 数据上报 | 云端看到 JSON |
| 5 | 云指令 | 云端下发 → 设备响应 |

### 🟡 Task 5.2: 稳定性（锦上添花）

24h 连续运行 + 内存/栈监控。

> 有时间做，答辩一句"通过 24 小时稳定性测试"很加分。没时间可跳过。

---

## Part B: 产出物（3 件，对应 demand.md）

### 🔴 Task 5.3: 作品设计报告（PDF）

**负责人：C 统稿** | 预计：3 天 | 大小：≤50MB

模板见 `report-workflow/template.md`，当前稿见 `report-workflow/competition_report.md`。

5 部分结构：
```
第一部分 作品概述（功能/应用/技术特点/性能指标/创新点/设计流程）
第二部分 系统组成及功能说明（硬件+软件，图文结合）
第三部分 完成情况及性能参数（实物照片为主！）
第四部分 总结（扩展之处+心得体会）
第五部分 参考文献
```

> ⚠️ 缺实物照片（第三部分），等 Task 5.1 完成后补拍。

### 🔴 Task 5.4: 作品介绍视频（MP4）

**负责人：全员** | 预计：2h | 时长：≤3min | 大小：≤300MB

- 大赛统一封面（2 秒内）
- 重点：**作品演示**，切忌全 PPT 讲解
- 演示流程：NFC 激活 → GPS 定位 → 温湿度采集 → 数据上传 → 云端指令响应
- 匿名要求：无学校名称/logo/校徽/导师

### 🔴 Task 5.5: 作品重要代码（RAR）

**负责人：C 打包** | 预计：0.5h | 大小：≤100MB

打包内容：
- `test1/Core/` 全部源码
- 排除 `Drivers/`、`Middlewares/`（CubeMX 生成，非作品代码）
- 排除编译产物（`.o`、`.axf`、`.hex` 等）

```bash
git archive --format=zip --output=../CargoTracker_source.zip HEAD
# 或手动 rar 压缩
```

> 代码注释中不要出现学校信息。
