MashedPotato817/CargoTracker-STM32H7/doc-workflow/archive/logs/logC-log4.md

# C组应用集成开发日志 4

> 日期：2026-07-07
> 范围：W 分支审核合并、Task 2.6 CubeMX 部分、CubeMX 重新生成后修复、文档更新
> 基于 commit `a44ffc2`（merge W 后 main）

## 本次目标

1. 审核并合并 W 分支到 main
2. CubeMX 重新生成 → PB0 改为 AIR780E_PWRKEY（Task 2.6 CubeMX 部分）
3. 修复 CubeMX 重新生成后的代码/工程还原问题
4. 更新项目文档至当前状态

## W 分支审核合并

### 纳入内容

| 模块 | 改动 |
|---|---|
| `i2c.c/h` | 新增 HAL I2C1 初始化模块 |
| `spi.c/h` | 新增 HAL SPI1 初始化模块 |
| `usart.c/h` | 新增 USART1/USART2 HAL 初始化 + MSP |
| `gpio.c` | 新增 W25Q128_CS / Buzzer / Alarm LED 引脚 |
| `main.c` | 调用 I2C1/SPI1/USART1/USART2 初始化 |
| `air780e.c` | 真 HAL UART AT 命令实现（条件编译保护） |
| `air780e/mqtt.c` | 真 UART MQTT 路径 |
| `gps.c` | 真 HAL UART NMEA 读取，GPS_Init 重配 9600 baud |
| `w25q128.c` | 扇区擦除 + 读数据 + 写后校验 |
| 团队日志 | A/B/C 组开发日志 + Keil 构建日志 |

### 排除内容

- `.gitignore` / `CLAUDE.md` / `GIT_WORKFLOW.md` — 保持 main 版本
- `.ioc` / `.uvprojx` / `system_stm32h7xx.c` / `port_1.__i` — 不纳入版本控制

### 合并后 Keil 编译修复

W 合并后 main 分支 Keil 工程缺失以下文件引用，手动添加到 `.uvprojx`：

| 文件 | 路径 |
|---|---|
| `i2c.c` | `../Core/Src/i2c.c` |
| `spi.c` | `../Core/Src/spi.c` |
| `stm32h7xx_hal_spi.c` | `../Drivers/.../stm32h7xx_hal_spi.c` |
| `stm32h7xx_hal_spi_ex.c` | `../Drivers/.../stm32h7xx_hal_spi_ex.c` |

修复后编译 0 Error 0 Warning。

## Task 2.6 CubeMX 部分 — PB0 → AIR780E_PWRKEY

CubeMX 操作：
- PB0：从 LD1_GREEN 改为 GPIO_Output，标签 `AIR780E_PWRKEY`
- 心跳灯保持 PE1（LD2_YELLOW）
- Generate Code

自动生效：
- `main.h`：`#define AIR780E_PWRKEY_Pin GPIO_PIN_0`、`AIR780E_PWRKEY_GPIO_Port GPIOB`
- `power.c`：`#if defined(AIR780E_PWRKEY_GPIO_Port)` 条件编译路径自动激活

## CubeMX 重新生成后修复（11 项）

每次 CubeMX Generate Code 会还原 `.uvprojx`、部分 source 和 header 文件。按 TROUBLESHOOTING.md 清单修复：

| # | 文件 | 问题 | 修复 |
|---|---|---|---|
| ① | `usart.h` | 丢失 huart1/huart2 声明 | 加 extern + 函数原型 |
| ② | `usart.c` | 丢失 huart1/huart2 定义+MSP | git checkout 恢复 |
| ③ | `main.c` | 丢失 I2C/SPI/USART init 调用 | 补 include + 4 行 init |
| ④ | `main.h` | 丢失 W25Q128_CS/Buzzer/LED | 补 3 组引脚宏 |
| ⑤ | `gpio.c` | 丢失 GPIOA+W25Q128_CS+Buzzer+LED | 补时钟和初始化 |
| ⑥ | `hal_conf.h` | SPI 模块注释 | 取消注释 HAL_SPI_MODULE_ENABLED |
| ⑦ | `FreeRTOSConfig.h` | FPU 还原=0 | 改回 1 |
| ⑧ | `.uvprojx` | Include Path 含 RVDS | 删除 RVDS 路径 |
| ⑨ | `.uvprojx` | RVDS port.c 条目 | 删除整个 File 块 |
| ⑩ | `.uvprojx` | Flash UL2CM3.DLL | 改 UL2V8M.DLL |
| ⑪ | `.uvprojx` | system_stm32h7xx.c 路径 | 改 Templates/ |

## 文档更新

- `current_status.md` — 全量重写至 Task 2 代码完成状态
- `task2.md` — 前置条件打勾，2.1~2.6 逐项标注完成/阻塞
- `hardware_map.md` — 外设表 + CubeMX 状态表更新
- `CLAUDE.md` — PB0 冲突标注、驱动标志位补充、代码结构更新
- `GIT_WORKFLOW.md` — 分支图更新（W 已合并）

## 当前状态

- 所有驱动标志位 `USE_HAL_*=1`，FPU=1
- PB0 已在 CubeMX 侧改为 AIR780E_PWRKEY
- Keil 编译 0 Error 0 Warning
- **阻塞项**：硬件验证全部未做（无外围模块连接）
- **下一步**：Task 2.6 代码侧（power.c PWRKEY 时序 + alarm.c 蜂鸣器/LED）

## 未修改

- 未修改 `Drivers/` 官方 HAL/CMSIS
- 未修改 A/B 组驱动实现
- 未连接任何外部硬件
