MashedPotato817/CargoTracker-STM32H7/pic/1 3.4状态机 （8状态循环）.png

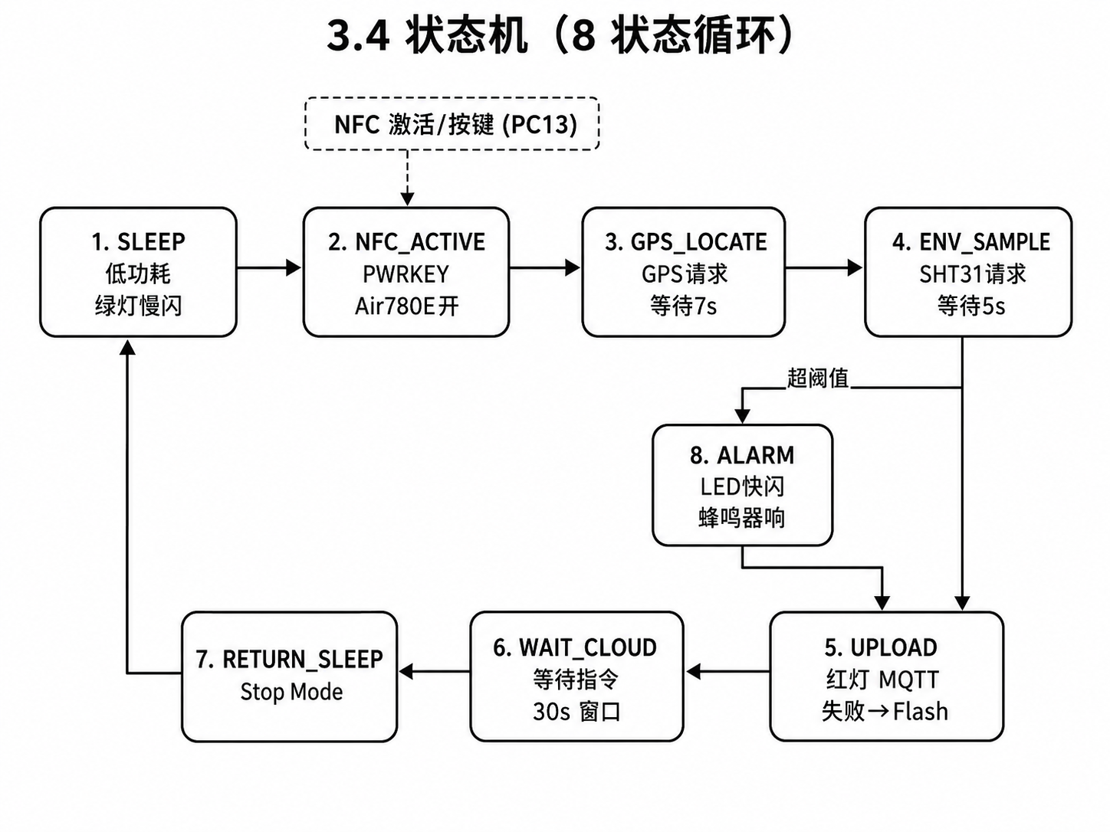
pic/1 3.4状态机 （8状态循环）.png
