MashedPotato817/CargoTracker-STM32H7/pic/2 嵌入式软件分层架构图.png

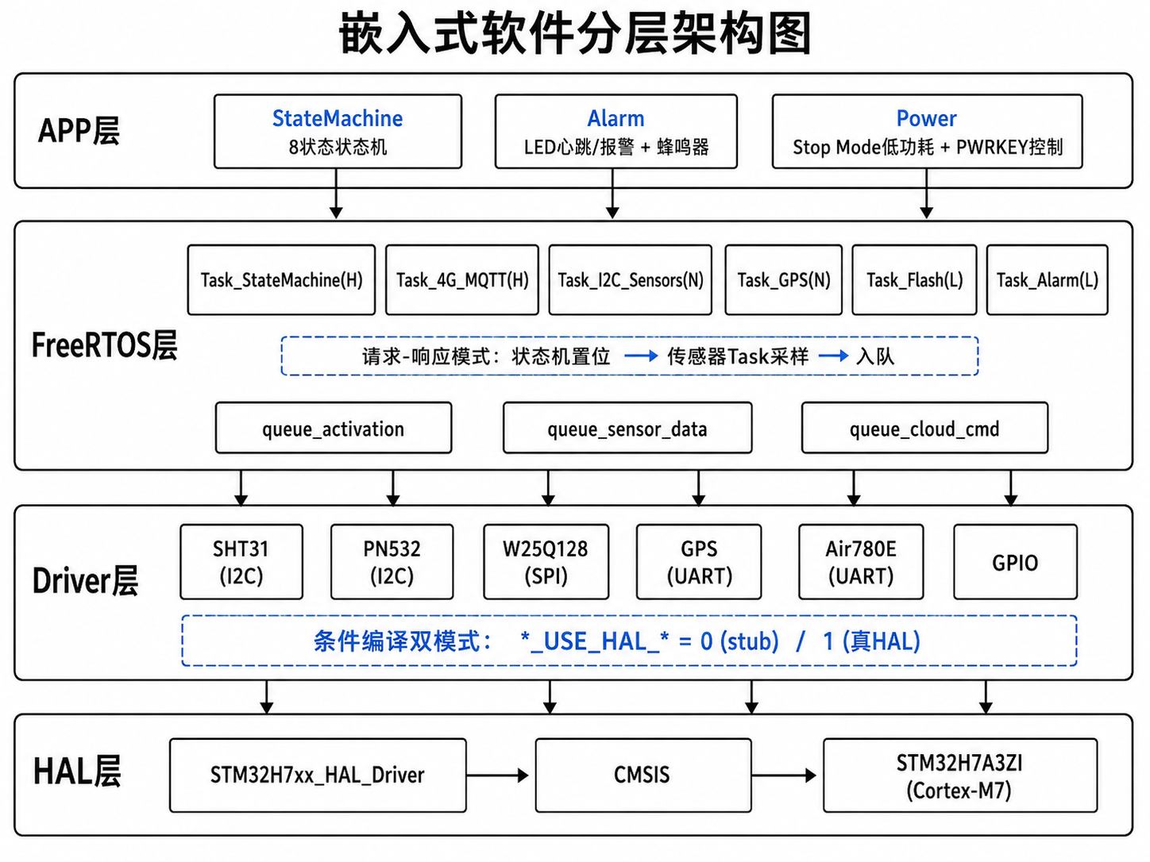
pic/2 嵌入式软件分层架构图.png
