MashedPotato817/CargoTracker-STM32H7/pic/3 嵌入式系统状态机流转图.png

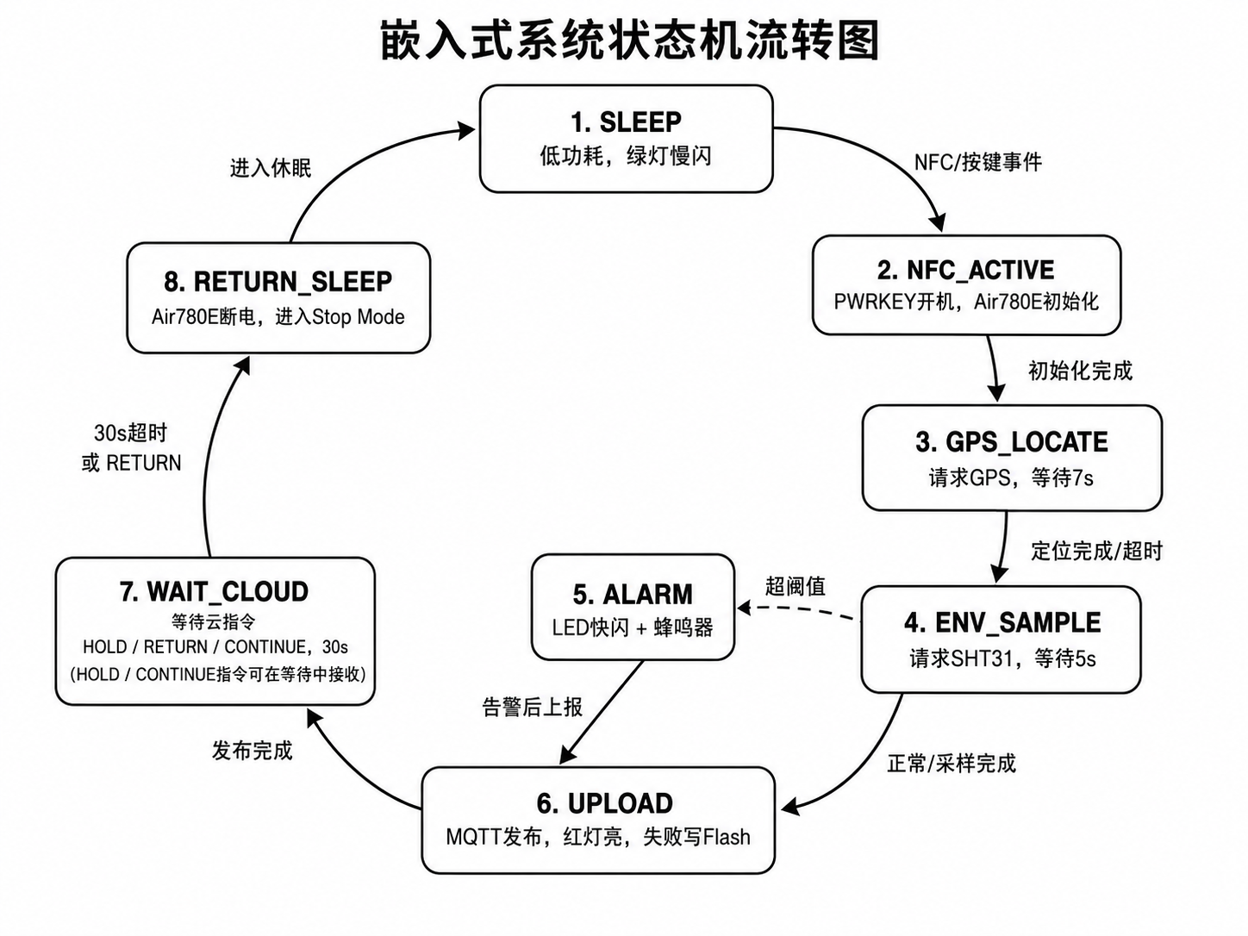
pic/3 嵌入式系统状态机流转图.png
