MashedPotato817/CargoTracker-STM32H7/pic/4 MQTT端到端通信时序图.png

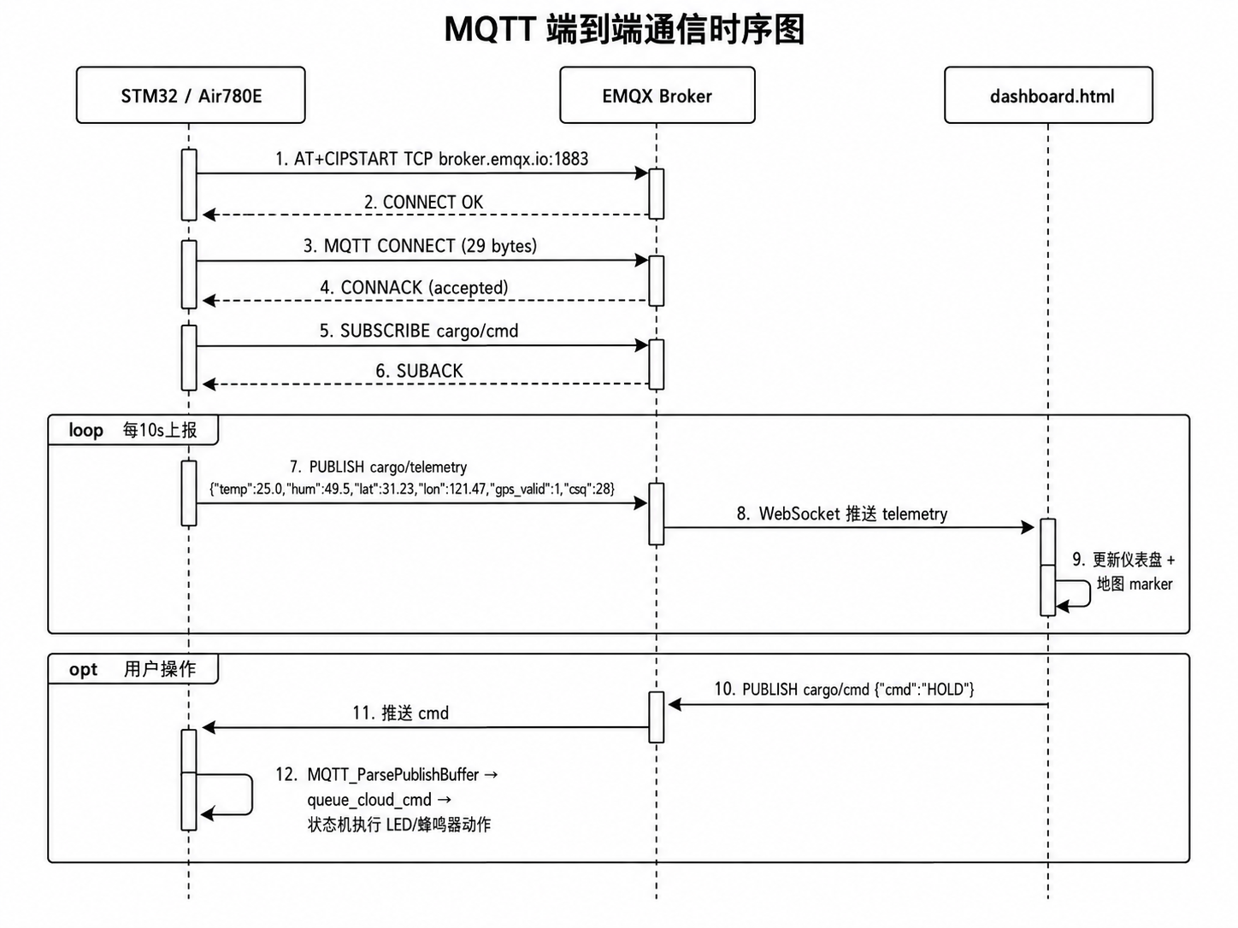
pic/4 MQTT端到端通信时序图.png
