MashedPotato817/CargoTracker-STM32H7/pic/6 嵌入式系统电源树拓扑图.png

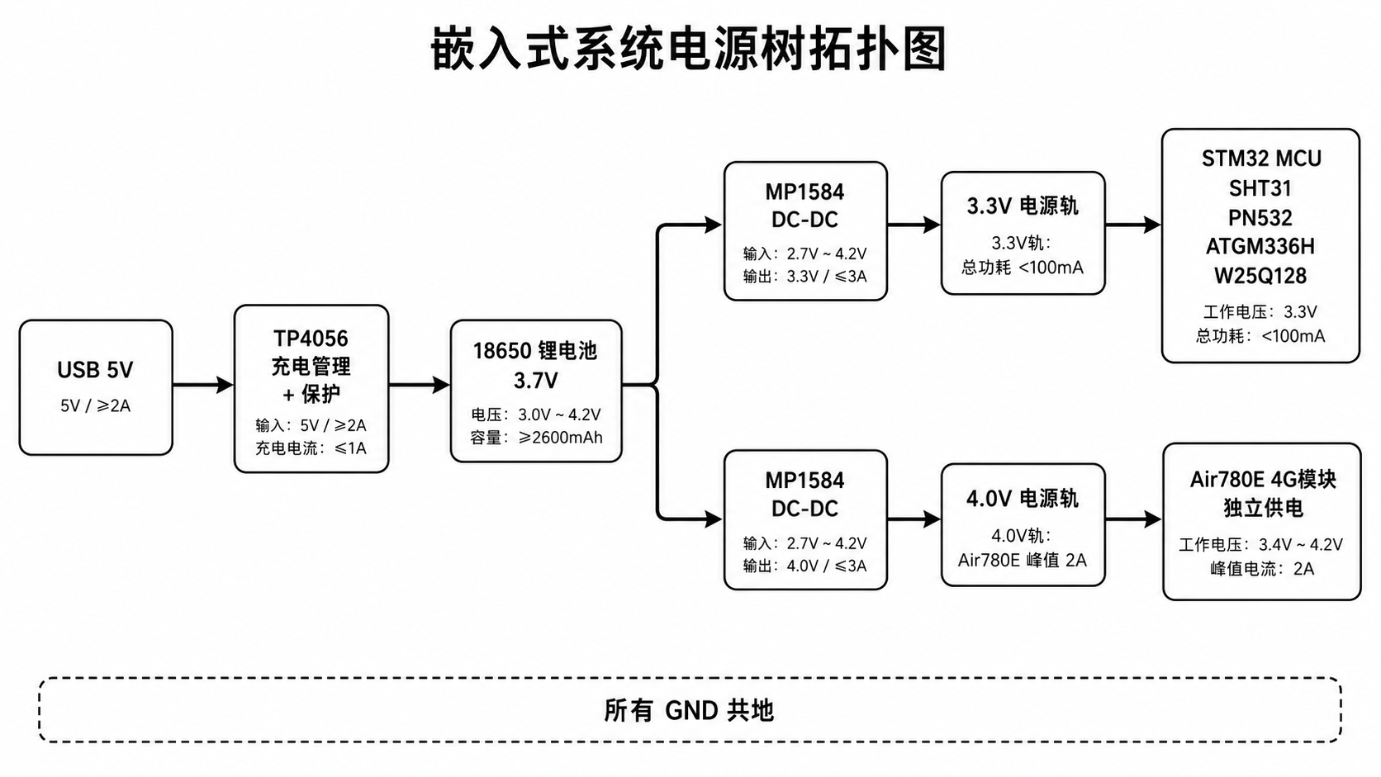
pic/6 嵌入式系统电源树拓扑图.png
