MashedPotato817/CargoTracker-STM32H7/pic/AIR780通信天线.png

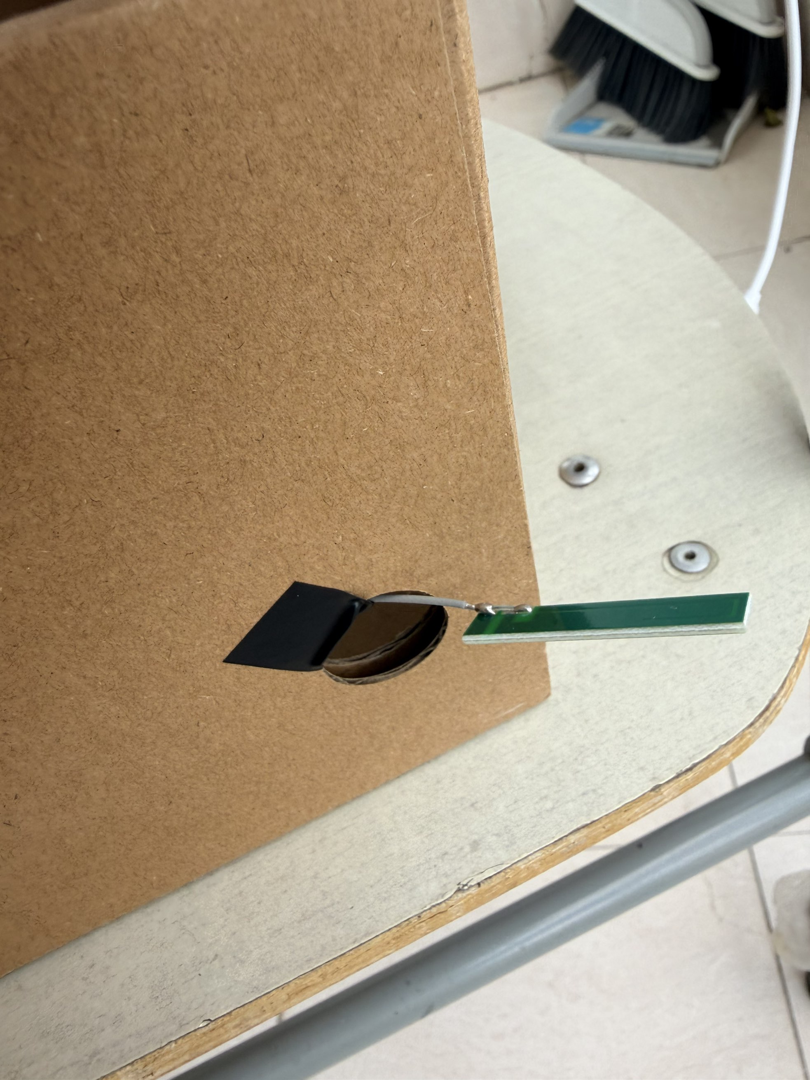
pic/AIR780通信天线.png
