MashedPotato817/CargoTracker-STM32H7/pic/CargoTracker 云端控制台 after.png

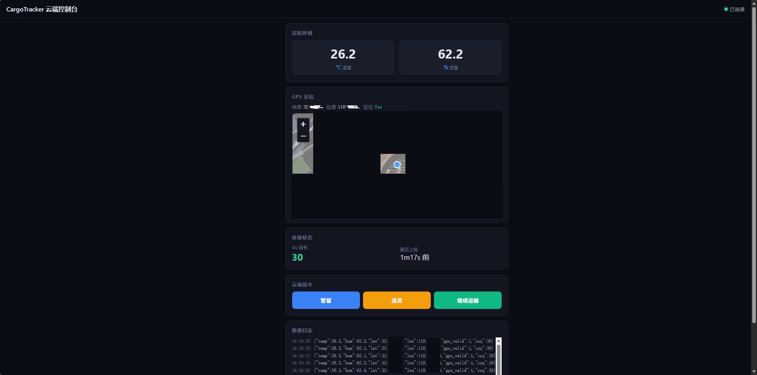
pic/CargoTracker 云端控制台 after.png
