MashedPotato817/CargoTracker-STM32H7/pic/GPS天线.png

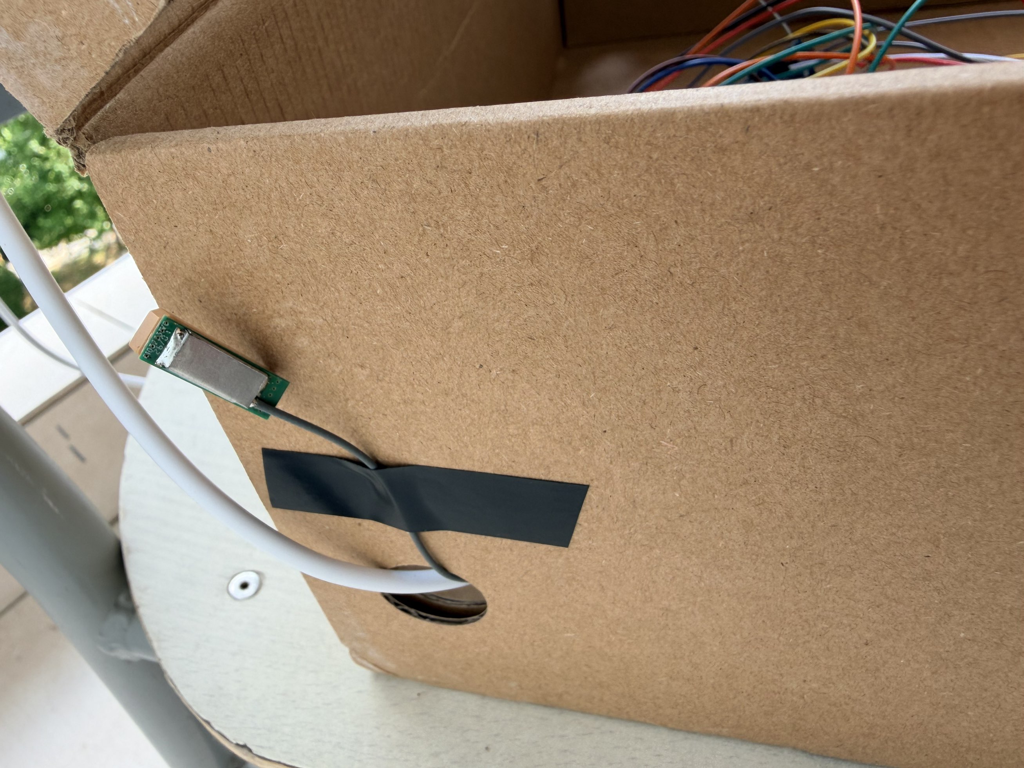
pic/GPS天线.png
