MashedPotato817/CargoTracker-STM32H7/user-manual-md/zh.md

# UM1727 用户手册
## STM32 Nucleo板软件开发工具入门

**DocID025840 Rev 1 [English Rev 5]**  
**2019年3月**

---

## 引言

STM32 Nucleo板是一种低成本且易于使用的开发平台，可使用STM32 32引脚、64引脚和144引脚封装进行快速评估并开始开发。

本文档将指导初学者如何构建和运行应用程序示例，以及构建和调试自己的应用程序。其结构如下：
- 第一章描述软件和硬件要求（一些支持STM32系列的工具链、ST-LINK/V2-1安装和固件包内容）。
- 第二章提供关于如何使用一些工具链构建和调试应用程序的分步指南：
  - IAR systems®公司开发的IAR Embedded Workbench® for ARM®（EWARM）
  - Keil®公司开发的Microcontroller Development Kit for ARM®（MDK-ARM）
  - Atollic®公司开发的TrueSTUDIO®
  - AC6公司开发的System Workbench for STM32（SW4STM32）

本手册并未涵盖与软件开发环境相关的所有主题，但是演示了编译器/调试器入门所需的基本步骤，并提供了全面理解每个步骤所需的文档的链接。

支持STM32 MCU Nucleo系列包括的所有板。

---

## 目录

1. 系统要求
2. 支持STM32系列的IDE
3. ST-LINK/V2-1安装
4. 固件包
   - 4.1 使用软件工具链执行和调试固件
     - 4.1.1 EWARM工具链
     - 4.1.2 MDK-ARM工具链
     - 4.1.3 TrueSTUDIO工具链
     - 4.1.4 SW4STM32工具链
5. 版本历史

---

## 1 系统要求

开始前，用户应：
1. 安装首选的Integrated Development Environment（IDE）。
2. ST-LINK/V2-1驱动程序将自动安装。如果遇到问题，用户可以继续从工具链安装目录手动安装驱动程序（详情见第3节）。
3. 从网页 www.st.com/stm32nucleo 下载STM32 Nucleo固件。
4. 为了与STM32 Nucleo板建立连接，将Nucleo板的连接器CN1连接到PC的USB端口（图2、图3和图4中用红圈标出了连接器CN1）。

上述步骤将在后续章节中详细介绍。

> **注：** 嵌入式ST-LINK/V2-1只支持STM32器件的SWD接口。

---

## 2 支持STM32系列的IDE

意法半导体基于32位ARM® Cortex®-M内核的STM32系列微控制器得到了一整套软件工具的支持。它整合了传统集成式开发环境IDE和主要第三方提供的C/C++编译器和调试器（免费版本可提供多达64KB的代码，具体取决于第三方），并以ST的创新工具作为补充。

支持所有Nucleo板的工具链：
- **EWARM v7.10.3或更高版本**(a)
  - 30天评估版
  - 32-Kb上限快速入门版本（Cortex M0限16-Kb）
- **MDK-ARM v5.17或更高版本**(a)(b)
  - MDK-Lite（32-Kb代码大小限制）
- **TrueSTUDIO Lite v5或更高版本**(b)
  - 无限制
- **SW4STM32 v1.5及更高版本**(a)
  - 无限制

> a. 需要先注册再下载。  
> b. 器件支持包独立于MDK-ARM发布。

---

## 3 ST-LINK/V2-1安装

所有STM32 Nucleo板都包含ST-LINK/V2-1嵌入式调试工具接口。此接口需要安装专用USB驱动程序。此驱动程序可以在ST网站 www.st.com 上找到且可以在以下软件工具链中使用：

- **用于ARM（EWARM）的IAR Embedded Workbench**  
  该工具链默认安装在PC本地硬盘上的 `C:\Program Files\IAR Systems\Embedded Workbench x.x` 目录下。在安装EWARM后，通过运行 `[IAR_INSTALL_DIRECTORY]\Embedded Workbench x.x\arm\drivers\ST-Link\ST-Link_V2_USBdriver.exe` 中的 `ST-Link_V2_USB.exe` 安装ST-LINK/V2-1驱动程序。

- **Keil微控制器开发套件（MDK-ARM）工具链**  
  该工具链默认安装在PC本地硬盘上的 `C:\Keil` 目录下；安装程序将在开始菜单中创建µVision5快捷方式。在连接ST-LINK/V2-1工具时，PC检测新硬件并要求安装ST-LINK_V2_USB驱动程序。屏幕上显示“找到新硬件向导”，它将指导用户完成从推荐位置安装驱动程序所需的步骤。

- **Atollic TrueSTUDIO STM32**  
  该工具链默认安装在PC本地硬盘上的 `C:\Program Files\Atollic` 目录下。在安装软件工具链时自动安装ST-Link_V2_USB.exe文件。

- **AC6 System Workbench for STM32（SW4STM32）**  
  该工具链默认安装在PC本地硬盘上的 `C:\Program Files\AC6` 目录下。在安装软件工具链时自动执行ST-Link_V2_USB.exe文件。

---

## 4 固件包

STM32 Nucleo示例、应用程序和演示包含在同一个.zip文件中。解压缩.zip文件生成一个文件夹，即STM32_Nucleo_FW_VX.Y.Z，其中包含以下子文件夹：

- **项目模板**：是一个预配置项目，其主要功能为空，将由用户自定义。它可以用来根据外设驱动程序创建应用程序。
- **项目示例**：包含每个可以直接运行的外设示例的工具链项目。
- **应用程序**：包含一组可以直接运行的应用程序。
- **演示**：包含可以直接运行的演示固件。

### 4.1 使用软件工具链执行和调试固件

下列步骤可以应用于STM32_Nucleo_FW_VX.Y.Z固件中的现有示例、演示或项目模板。首先，用户必须阅读固件/readme.txt文件，其中包含固件说明和硬件/软件要求。

#### 4.1.1 EWARM工具链
1. 打开IAR Embedded Workbench for ARM（EWARM）。
2. 在文件菜单中，选择打开并点击工作区以显示“打开工作区”对话框。浏览并选中一个示例或演示或模板工作区文件，点击打开以在“项目”窗口中启动它。
3. 在项目菜单中，选择全部重建以编译项目。
4. 更改项目设置路径：
   - Include目录：项目 > 选项… > C/C++编译器 > 
   - 预处理器定义：项目 > 选项… > C/C++编译器 > 预处理器 >
5. 从项目菜单中选择下载和调试或点击工具栏中的按钮，对Flash存储器进行编程并开始调试。
6. 调试器可用于C语言和汇编语言调试、设置断点及监控变量。

#### 4.1.2 MDK-ARM工具链
1. 打开Keil MDK-ARM微控制器开发套件（µvision5 IDE）。
2. 在项目菜单中选择打开项目...，浏览并选中文件启动项目。
3. 在项目菜单中，选择重建所有目标文件以编译项目。
4. 更改项目设置路径：
   - Include目录：项目 > 目标选项 > C/C++ > Include路径
   - 预处理器定义：项目 > 目标选项 > C/C++ > 预处理器符号 > 定义
5. 从调试菜单中选择开始/停止调试会话或点击工具栏按钮进行编程和调试。

#### 4.1.3 TrueSTUDIO工具链
1. 打开Atollic TrueSTUDIO，选择工作区位置。
2. 浏览并选中TrueSTUDIO工作区加载。
3. 从文件菜单中选择导入 > General > Existing Projects into Workspace。
4. 选择根目录并浏览至工作区文件夹，选中项目并点击完成。
5. 在项目管理器中选中项目，打开项目菜单并点击构建项目。
6. 更改设置：项目 > 属性 > C/C++构建 > 设置。
7. 按下F11键启动调试会话。

#### 4.1.4 SW4STM32工具链
1. 打开AC6 SW4STM32，选择工作区位置。
2. 浏览并选中SW4STM32工作区加载。
3. 从文件菜单中选择导入 > General > Existing Projects into Workspace。
4. 选择根目录并浏览至工作区文件夹，选中项目并点击完成。
5. 在项目管理器中选中项目，构建项目。
6. 更改设置：项目 > 属性 > C/C++构建 > 设置。
7. 按下F11键启动调试会话。

---

## 5 版本历史

| 日期 | 版本 | 变更 |
| :--- | :--- | :--- |
| 2014年5月19日 | 1 | 初始版本 |
| 2014年6月20日 | 2 | 在封页上添加了新的产品编号。删除了表1“Nucleo板一般信息”。 |
| 2014年9月9日 | 3 | 用“STM32 MCU Nucleo”系列替换了文档中出现的所有NUCLEO。 |
| 2015年11月30日 | 4 | 增加了第4.1.4节：SW4STM32工具链。更新了引言、第3节、第4节。 |
| 2016年1月19日 | 5 | 更新了引言和第1节以介绍Nucleo 144板。 |

**中文文档版本历史**

| 日期 | 版本 | 变更 |
| :--- | :--- | :--- |
| 2019年3月26日 | 1 | 中文初始版本 |

---

## 重要通知-请仔细阅读

意法半导体公司及其子公司（“ST”）保留随时对ST产品和/或本文档进行变更、更正、增强、修改和改进的权利，恕不另行通知。买方在订货之前应获取关于ST产品的最新信息。ST产品的销售依照订单确认时的相关ST销售条款。

© 2019 STMicroelectronics-保留所有权利
