MashedPotato817/CargoTracker-STM32H7/doc-workflow/TROUBLESHOOTING.md

# 踩坑记录

> 遇到问题解决后马上记到这里，队友 pull 后直接搜索即可，不用重复踩坑。

---

## CubeMX

### 1. HSE 晶振陷阱

**现象**：编译通过，烧录后程序卡死——串口无输出、LED 不闪。

**原因**：NUCLEO-H7A3ZI-Q 开发板**没有 HSE 外部晶振**。CubeMX 默认启用 HSE，`SystemClock_Config()` 中等待 HSE 就绪超时死循环。

**解决**：CubeMX → Clock Configuration → PLL Source Mux → 选 **HSI**（内部 64MHz RC），重新生成代码。

---

### 2. CubeMX 提示 "Open Project" 时不要点

**现象**：CubeMX 生成代码后弹出"Open Project"，点击后 STM32CubeIDE 报错打不开。

**原因**：工程是 Keil MDK 格式，CubeMX 内建 IDE 打不开。忽略弹窗，直接用 Keil 手动打开 `test1.uvprojx`。

---

### 3. CubeMX 重新生成后必查清单

每次 CubeMX **GENERATE CODE** 之后，Keil 编译前检查以下 4 项（CubeMX 可能还原或改错）：

**① system_stm32h7xx.c 路径**

CubeMX 可能把该文件放在 `Drivers/CMSIS/.../Templates/` 下，但 uvprojx 引用的是 `Core/Src/`。编译报 `no such file or directory` 时，在 uvprojx 中把 FilePath 改为实际路径：
```
../Drivers/CMSIS/Device/ST/STM32H7xx/Source/Templates/system_stm32h7xx.c
```

**② FreeRTOS Include Path**

CubeMX 会还原为默认的 `RVDS/ARM_CM4F`。确认 Include Path 是：
```
../Middlewares/Third_Party/FreeRTOS/Source/portable/GCC/ARM_CM7/r0p1
```

**③ Flash 烧录算法**

CubeMX 可能改 `<Flash2>` 为 `UL2CM3.DLL`（Cortex-M3 用）。确认是：
```xml
<Flash2>BIN\UL2V8M.DLL</Flash2>
```

**④ MicroLIB**

确认 Options for Target → Target → **Use MicroLIB** 已勾选（printf 依赖）。

---

## Keil MDK

### 3. Cannot Load Flash Programming Algorithm

**现象**：烧录时报 `Cannot Load Flash Programming Algorithm`。

**解决**：Keil → Flash → Configure Flash Tools → Debug → Settings → Flash Download → 点 Add → 选 STM32H7x 512KB → RAM for Algorithm:

```
Start : 0x24000000
Size  : 0x00010000
```

---

## FreeRTOS

### 4. 栈溢出（Stack Overflow）

**现象**：某个 task 跑着跑着不打印了，或进 HardFault。

**原因**：task 栈太小。注意 CubeMX 中 Stack Size 单位是 **Words（4 字节）**，256 Words = 1KB。

**建议**：
- 用 `uxTaskGetStackHighWaterMark(NULL)` 查当前 task 的剩余栈空间
- printf 大量使用时栈要更大（格式化字符串占栈）
- `Task_4G_MQTT` 和 `Task_StateMachine` 栈建议 ≥ 1KB

---

### 5. TIM6 被 FreeRTOS 占用

**现象**：CubeMX 中 TIM6 显示黄色感叹号，提示冲突。

**原因**：FreeRTOS CMSIS_V2 用 TIM6 做 HAL 时钟基准（`HAL_InitTick`）。

**解决**：正常现象，忽略即可。自己的应用代码用其他定时器（TIM2~TIM5 等）。

---

### 6. Task Stack Size 最小 128 Words

**现象**：CubeMX 任务栈大小字段无法输入小于 128 的值。

**原因**：FreeRTOS CMSIS_V2 强制最小 task 栈为 128 Words（512 字节）。

**解决**：所有 task 栈均为 ≥ 128 Words。即使简单 task（如 LED 闪烁）也填 128，512B 对 STM32H7 的 1.4MB RAM 来说微不足道。

---

### 7. ARM Compiler 6 + FreeRTOS RVDS port = 177 个编译错误

**现象**：编译报大量 `__forceinline` / `__asm` unknown type / `PRESERVE8` undeclared 错误（~177 个），所有 FreeRTOS 源文件都报。

**原因**：CubeMX 默认添加 FreeRTOS 的 `RVDS` port（ARM_CM4F 或 ARM_CM7），RVDS = ARM Compiler 5 (armcc) 语法。Keil 如果选了 **ARM Compiler 6 (V6.x / armclang)**，不认 `__forceinline`、`__asm` 等 AC5 关键字。

**解决**：改用 `GCC/ARM_CM7` port（armclang 兼容 GCC 语法）。

三步操作（以 STM32H7 为例）：

1. **复制 GCC port 文件** — 从 `STM32Cube_FW_H7_Vx.x.x/Middlewares/Third_Party/FreeRTOS/Source/portable/GCC/ARM_CM7/r0p1/` 复制 `port.c` + `portmacro.h` 到工程的同路径 `portable/GCC/ARM_CM7/r0p1/` 下

2. **修改 uvprojx**（或 Keil 界面操作）：
   - Include Path：`RVDS\ARM_CM7\r0p1` → `GCC\ARM_CM7\r0p1`
   - port.c 文件引用：`RVDS\ARM_CM7\r0p1\port.c` → `GCC\ARM_CM7\r0p1\port.c`

3. **Keil 重开工程 → Rebuild all**

**验证**：编译 0 错误。

> 注意 1：H7 是 Cortex-M7，ARM_CM7 里还有 `r0p1` 子文件夹（区分内核版本），Include Path 要写到底层 `r0p1` 目录。  
> 注意 2：如果 CubeMX 重新生成代码，可能会恢复 Include Path，需要重新改一回。可在 CLAUDE.md 中注明此操作。

---

## Git

### 8. CubeMX 重新生成后文件冲突

**现象**：CubeMX 重新生成后 `git diff` 一片红，分不清哪些是配置变更、哪些是覆盖。

**原因**：CubeMX 会覆盖 `/* USER CODE BEGIN/END */` 段以外的所有内容。

**最佳实践**：
1. 改 CubeMX 前先 `git commit`（干净状态）
2. CubeMX 生成后再 `git diff` 一目了然
3. 所有自定义代码必须写在 `USER CODE` 段内

---

### 9. FPU 未启用导致浮点运算性能差

**现象**：SHT31 温度转换、GPS 坐标解析等浮点运算极慢。

**原因**：`FreeRTOSConfig.h` 中 `configENABLE_FPU=0`，Cortex-M7 硬件 FPU 被禁用，所有 float 运算走软件模拟。

**解决**：

```c
// FreeRTOSConfig.h
#define configENABLE_FPU    1   // 启用硬件 FPU
#define configENABLE_MPU    0   // 保持禁用（FreeRTOS MPU wrapper 未使用）
```

> 注意：CubeMX 可能不会自动打开此项，需手动修改 FreeRTOSConfig.h。

---

### 10. PB0 引脚冲突：LD1_GREEN vs Air780E PWRKEY

**现象**：硬件到齐后发现 PB0 同时用于心跳灯（LD1_GREEN）和 Air780E 4G 模块电源控制（PWRKEY）。如果 CubeMX 生成的 `gpio.c` 仍把 PB0 和 LED 一起初始化为 LOW，Air780E 所有 AT 指令会 timeout，模块完全无响应。

**原因**：stub 阶段 PB0 被配置为 LD1_GREEN 指示灯，但设计文档中 PB0 是 Air780E PWRKEY。LED 的 LOW 可能表示熄灭，但 PWRKEY 的 LOW 表示按下/拉到 GND；持续 LOW 会让 Air780E 保持关机。

**解决**：
1. 心跳灯迁移到 PE1（LD2_YELLOW），通过不同闪烁模式区分心跳（慢闪）和报警（快闪）
2. PB0 释放为 Air780E PWRKEY（GPIO_Output）
3. C 组负责统一修改 CubeMX 并协调 A/B 组

`gpio.c` 初始电平必须分开写，PWRKEY 默认释放为 HIGH：

```c
HAL_GPIO_WritePin(GPIOB, LD3_RED_Pin, GPIO_PIN_RESET);
HAL_GPIO_WritePin(GPIOB, AIR780E_PWRKEY_Pin, GPIO_PIN_SET);
```

> 注意：此变更必须由 C 组统一操作，A/B 组禁止单独使用 PB0。

---

### 11. Keil uvoptx 残留 RVDS port.c

**现象**：`test1.uvprojx` 中已经引用 `GCC/ARM_CM7/r0p1/port.c`，但 Keil 命令行构建仍然额外编译：

```text
../Middlewares/Third_Party/FreeRTOS/Source/portable/RVDS/ARM_CM4F/port.c
```

并报 `__asm`、`PRESERVE8`、`uxCriticalNesting` 等 ARM Compiler 6 不兼容错误。

**原因**：`test1/MDK-ARM/test1.uvoptx` 中残留了旧的 RVDS `port.c` 文件条目。Keil 可能继续把该用户选项文件里的旧条目带入构建，即使 `.uvprojx` 已经改正确。

**解决**：

1. 搜索 Keil 工程目录：

```powershell
rg -n "RVDS|ARM_CM4F|port.c" test1/MDK-ARM
```

2. 确认 `.uvprojx` 只保留：

```text
..\Middlewares\Third_Party\FreeRTOS\Source\portable\GCC\ARM_CM7\r0p1\port.c
```

3. 删除 `test1.uvoptx` 中指向 `portable/RVDS/ARM_CM4F/port.c` 的旧 `<File>...</File>` 块。
4. 重新运行 Keil 命令行构建，确认只编译一个 `port.c`，结果为 0 Error / 0 Warning。

---

### 12. USART2 默认 115200 与 GPS 9600 不匹配

**现象**：CubeMX 已生成 `huart2` / `MX_USART2_UART_Init()`，PD5/PD6 引脚也正确，但 `usart.c` 中 USART2 baud rate 仍是 115200。ATGM336H GPS 默认输出通常为 9600 baud，串口波特率不匹配会导致 NMEA 数据乱码或读取超时。

**原因**：CubeMX 使能 USART2 时如果没有手动修改参数，会保留默认 115200。

**解决**：

1. 最佳做法：回到 CubeMX，将 USART2 Baud Rate 改为 `9600`，重新生成代码。
2. 临时兼容：在 GPS 模块初始化中检测 `huart2.Init.BaudRate`，若不是 `9600`，调用 `HAL_UART_Init(&huart2)` 重新初始化为 9600。

> 注意：最终提交前建议仍以 CubeMX 配置为准，避免后续重新生成代码后再次出现参数漂移。

---

### 13. CubeMX Generate Code 后必做三步修复

**现象**：每次 CubeMX Generate Code 后，以下三个设置被覆盖，导致编译 177 错误或硬件不工作。

**原因**：这三个配置都在 `USER CODE BEGIN/END` 段外，CubeMX 无法保留。

**解决**：Generate Code 后立即执行以下三步：

**Step 1: 修复 FreeRTOS port（否则 177 编译错误）**

`test1.uvprojx` 中所有 `RVDS/ARM_CM4F` → `GCC/ARM_CM7/r0p1`

**Step 2: 恢复 FPU**

`Core/Inc/FreeRTOSConfig.h` 第 58 行：
```c
#define configENABLE_FPU    1   // CubeMX 默认 0，必须改
```

**Step 3: 恢复 Air780E PWRKEY**

`Core/Inc/main.h`：`LD1_GREEN_Pin/Port` → `AIR780E_PWRKEY_Pin/Port`

`Core/Src/gpio.c`：所有 `LD1_GREEN_Pin` → `AIR780E_PWRKEY_Pin`

> 如果不需要 Generate Code，这三步**不用做**。

---

### 14. GPS 上报位置大偏差：经纬度小数被截断

**现象**：GPS 已经能输出经纬度，但 dashboard 地图位置明显偏离实际位置，可能达到几十公里；串口日志或 MQTT payload 里只看到 `lat=31 lon=121` 这类整数坐标。

**原因**：GPS 解析得到的是十进制度数 float，例如 `31.230400, 121.473700`，但 MQTT 上报或调试日志如果用 `(int)` 转换，会丢掉小数部分。地图收到 `31,121` 后会定位到整数经纬度位置，偏差非常大。

**解决**：

1. MQTT payload 中 `lat/lon` 必须保留小数，至少 5~6 位，例如 `31.230400`。
2. 在 Keil/MicroLIB 环境下不要直接依赖 `%f`，推荐把坐标按 `1000000` 放大为整数后手工拼出小数字符串。
3. 串口 GPS sample 日志也应打印小数和 `valid`，避免误判 GPS 解析仍是 stub 整数。

**验证**：MQTT 日志应从：

```text
{"temp":24,"hum":49,"lat":31,"lon":121,"gps_valid":1}
```

变为：

```text
{"temp":24,"hum":49,"lat":31.230400,"lon":121.473700,"gps_valid":1}
```

---

### 15. 温湿度上报只有整数：float 被 MQTT payload 截断

**现象**：SHT31 真实采样有小数，但 dashboard 只显示 `24.0C / 49.0%` 这类整数小数形式，MQTT 日志为 `{"temp":24,"hum":49,...}`。

**原因**：`TelemetryData.env` 中温湿度是 float，但 MQTT payload 里如果用 `(int)` 转换，会把小数直接丢掉。dashboard 虽然调用 `toFixed(1)`，但收到的已经是整数，只能显示 `.0`。

**解决**：

1. MQTT payload 中 `temp/hum` 保留 1 位小数，例如 `24.5` / `49.3`。
2. 在 Keil/MicroLIB 环境下不要直接依赖 `%f`，推荐把数值按 `10` 放大为整数后手工拼出 1 位小数字符串。
3. SHT31 串口 sample 日志也同步打印 1 位小数，方便现场确认真实采样精度。

**验证**：MQTT 日志应从：

```text
{"temp":24,"hum":49,"lat":31.230400,"lon":121.473700,"gps_valid":1}
```

变为：

```text
{"temp":24.5,"hum":49.3,"lat":31.230400,"lon":121.473700,"gps_valid":1}
```
