MashedPotato817/CargoTracker-STM32H7/doc-workflow/keil_build_logA2.txt

*** Using Compiler 'V6.21', folder: 'E:\App\Keil_v5\ARM\ARMCLANG\Bin'
Build target 'test1'
compiling app.c...
compiling stm32h7xx_it.c...
compiling pn532.c...
compiling stm32h7xx_hal_msp.c...
compiling state_machine.c...
compiling usart.c...
compiling gps.c...
compiling power.c...
compiling stm32h7xx_hal_timebase_tim.c...
compiling alarm.c...
compiling freertos.c...
compiling sht31.c...
compiling gpio.c...
compiling main.c...
compiling air780e.c...
compiling mqtt.c...
compiling w25q128.c...
compiling stm32h7xx_hal_cortex.c...
compiling stm32h7xx_hal_tim_ex.c...
compiling stm32h7xx_hal_flash.c...
compiling stm32h7xx_hal_rcc.c...
compiling stm32h7xx_hal_gpio.c...
compiling stm32h7xx_hal_hsem.c...
compiling stm32h7xx_hal_flash_ex.c...
compiling stm32h7xx_hal_rcc_ex.c...
compiling stm32h7xx_hal_pwr.c...
compiling stm32h7xx_hal_dma_ex.c...
compiling stm32h7xx_hal_tim.c...
compiling stm32h7xx_hal_pwr_ex.c...
compiling stm32h7xx_hal_mdma.c...
compiling stm32h7xx_hal_dma.c...
compiling stm32h7xx_hal.c...
compiling stm32h7xx_hal_i2c_ex.c...
compiling stm32h7xx_hal_exti.c...
compiling port.c...
compiling system_stm32h7xx.c...
compiling stm32h7xx_hal_uart_ex.c...
compiling mpu_wrappers_v2.c...
compiling croutine.c...
compiling list.c...
compiling event_groups.c...
compiling stm32h7xx_hal_uart.c...
compiling stream_buffer.c...
compiling stm32h7xx_hal_i2c.c...
compiling heap_4.c...
compiling timers.c...
compiling queue.c...
compiling tasks.c...
compiling cmsis_os2.c...
linking...
Program Size: Code=34984 RO-data=2188 RW-data=48 ZI-data=20296  
FromELF: creating hex file...
"test1\test1.axf" - 0 Error(s), 0 Warning(s).
Build Time Elapsed:  00:00:04
