MashedPotato817/CargoTracker-STM32H7/doc-workflow/archive/debug/error1.md

Rebuild started: Project: test1
*** Using Compiler 'V6.21', folder: 'C:\Keil_MDK\ARM\ARMCLANG\Bin'
Rebuild target 'test1'
compiling usart.c...
compiling i2c.c...
compiling freertos.c...
compiling stm32h7xx_it.c...
compiling gpio.c...
compiling stm32h7xx_hal_timebase_tim.c...
compiling stm32h7xx_hal_msp.c...
compiling main.c...
compiling spi.c...
assembling startup_stm32h7a3xxq.s...
compiling stm32h7xx_hal_flash.c...
compiling stm32h7xx_hal_cortex.c...
compiling stm32h7xx_hal_rcc.c...
compiling stm32h7xx_hal_gpio.c...
compiling stm32h7xx_hal_flash_ex.c...
compiling stm32h7xx_hal_hsem.c...
compiling stm32h7xx_hal_tim_ex.c...
compiling stm32h7xx_hal_rcc_ex.c...
compiling stm32h7xx_hal_pwr.c...
compiling stm32h7xx_hal_i2c_ex.c...
compiling stm32h7xx_hal_exti.c...
compiling stm32h7xx_hal_dma_ex.c...
compiling stm32h7xx_hal_pwr_ex.c...
compiling stm32h7xx_hal.c...
compiling stm32h7xx_hal_mdma.c...
compiling mpu_wrappers_v2.c...
compiling stm32h7xx_hal_spi_ex.c...
compiling stm32h7xx_hal_dma.c...
compiling system_stm32h7xx.c...
compiling stm32h7xx_hal_uart_ex.c...
compiling list.c...
compiling croutine.c...
compiling event_groups.c...
compiling stm32h7xx_hal_tim.c...
compiling heap_4.c...
compiling stm32h7xx_hal_spi.c...
compiling port.c...
compiling timers.c...
compiling stream_buffer.c...
compiling queue.c...
compiling stm32h7xx_hal_uart.c...
compiling stm32h7xx_hal_i2c.c...
compiling tasks.c...
compiling cmsis_os2.c...
linking...
test1\test1.axf: Error: L6218E: Undefined symbol App_SendActivationFromISR (referred from main.o).
test1\test1.axf: Error: L6218E: Undefined symbol App_TaskStateMachine (referred from freertos.o).
test1\test1.axf: Error: L6218E: Undefined symbol App_Task4GMQTT (referred from freertos.o).
test1\test1.axf: Error: L6218E: Undefined symbol App_TaskI2CSensors (referred from freertos.o).
test1\test1.axf: Error: L6218E: Undefined symbol App_TaskGPS (referred from freertos.o).
test1\test1.axf: Error: L6218E: Undefined symbol App_TaskFlash (referred from freertos.o).
test1\test1.axf: Error: L6218E: Undefined symbol App_TaskAlarm (referred from freertos.o).
Not enough information to list image symbols.
Not enough information to list load addresses in the image map.
Finished: 2 information, 0 warning and 7 error messages.
"test1\test1.axf" - 7 Error(s), 0 Warning(s).
Target not created.
Build Time Elapsed:  00:00:02
