MashedPotato817/CargoTracker-STM32H7/test1/Core/Inc/main.h

#define OSC32_IN_Pin GPIO_PIN_14
#define OSC32_IN_GPIO_Port GPIOC
#define OSC32_OUT_Pin GPIO_PIN_15
#define OSC32_OUT_GPIO_Port GPIOC
#define PH0_MCU_Pin GPIO_PIN_0
#define PH0_MCU_GPIO_Port GPIOH
#define PH1_MCU_Pin GPIO_PIN_1
#define PH1_MCU_GPIO_Port GPIOH
#define AIR780E_PWRKEY_Pin GPIO_PIN_0
#define AIR780E_PWRKEY_GPIO_Port GPIOB
#define W25Q128_CS_Pin GPIO_PIN_4
#define W25Q128_CS_GPIO_Port GPIOA
#define LD3_RED_Pin GPIO_PIN_14
#define LD3_RED_GPIO_Port GPIOB
#define BUZZER_Pin GPIO_PIN_8
#define BUZZER_GPIO_Port GPIOC
#define ALARM_LED_Pin GPIO_PIN_9
#define ALARM_LED_GPIO_Port GPIOC
#define LD2_YELLOW_Pin GPIO_PIN_1
#define LD2_YELLOW_GPIO_Port GPIOE
