MashedPotato817/CargoTracker-STM32H7/test1/Core/Src/flash/w25q128.c

#include "flash/w25q128.h"

#include <stddef.h>
#include <stdio.h>
#include <string.h>
#include "main.h"
#include "air780e/mqtt.h"

#if W25Q128_USE_HAL_SPI
#include "spi.h"
#endif

#define W25Q128_CMD_WRITE_ENABLE 0x06U
#define W25Q128_CMD_READ_STATUS  0x05U
#define W25Q128_CMD_SECTOR_ERASE 0x20U
#define W25Q128_CMD_PAGE_PROGRAM 0x02U
#define W25Q128_CMD_READ_DATA    0x03U
#define W25Q128_CMD_JEDEC_ID     0x9FU
#define W25Q128_STATUS_BUSY      0x01U
#define W25Q128_STATUS_WEL       0x02U
#define W25Q128_TIMEOUT_MS       100U
#define W25Q128_ERASE_TIMEOUT_MS 4000U
#define W25Q128_TELEM_BASE_ADDR  0x000000U
#define W25Q128_TELEM_SLOT_SIZE  32U
#define W25Q128_TELEM_SLOTS      128U
#define W25Q128_SECTOR_SIZE      4096U
#define W25Q128_RECORD_MAGIC     0xA5C35A3CU
#define W25Q128_ERASED_MAGIC     0xFFFFFFFFU

static uint32_t write_slot = 0U;
static uint8_t cache_full = 0U;

typedef struct {
    float temperature_c;
    float humidity_percent;
    float latitude;
    float longitude;
    uint8_t env_valid;
    uint8_t gps_valid;
    uint8_t reserved[6];
    uint32_t magic;
} W25Q128TelemetryRecord;

#if W25Q128_USE_HAL_SPI
static void w25q128_select(void)
{
    HAL_GPIO_WritePin(W25Q128_CS_GPIO_Port, W25Q128_CS_Pin, GPIO_PIN_RESET);
}

static void w25q128_deselect(void)
{
    HAL_GPIO_WritePin(W25Q128_CS_GPIO_Port, W25Q128_CS_Pin, GPIO_PIN_SET);
}

static uint8_t w25q128_tx(const uint8_t *data, uint16_t len)
{
    return (HAL_SPI_Transmit(&hspi1, (uint8_t *)data, len,
                             W25Q128_TIMEOUT_MS) == HAL_OK) ? 1U : 0U;
}

static uint8_t w25q128_rx(uint8_t *data, uint16_t len)
{
    return (HAL_SPI_Receive(&hspi1, data, len, W25Q128_TIMEOUT_MS) == HAL_OK)
               ? 1U
               : 0U;
}

static uint8_t w25q128_read_status(uint8_t *status)
{
    uint8_t cmd = W25Q128_CMD_READ_STATUS;

    if (status == NULL) {
        return 0U;
    }

    w25q128_select();
    if ((w25q128_tx(&cmd, 1U) == 0U) || (w25q128_rx(status, 1U) == 0U)) {
        w25q128_deselect();
        return 0U;
    }
    w25q128_deselect();

    return 1U;
}

static uint8_t w25q128_write_enable(void)
{
    uint8_t cmd = W25Q128_CMD_WRITE_ENABLE;
    uint8_t status = 0U;

    w25q128_select();
    if (w25q128_tx(&cmd, 1U) == 0U) {
        w25q128_deselect();
        return 0U;
    }
    w25q128_deselect();

    if (w25q128_read_status(&status) == 0U) {
        return 0U;
    }

    return ((status & W25Q128_STATUS_WEL) != 0U) ? 1U : 0U;
}

static uint8_t w25q128_wait_ready(uint32_t timeout_ms)
{
    uint8_t cmd = W25Q128_CMD_READ_STATUS;
    uint8_t status = W25Q128_STATUS_BUSY;
    uint32_t start = HAL_GetTick();

    while ((HAL_GetTick() - start) < timeout_ms) {
        if (w25q128_read_status(&status) == 0U) {
            return 0U;
        }

        if ((status & W25Q128_STATUS_BUSY) == 0U) {
            return 1U;
        }
    }

    return 0U;
}

static uint8_t w25q128_sector_erase(uint32_t addr)
{
    uint8_t cmd[4];

    if (w25q128_write_enable() == 0U) {
        return 0U;
    }

    cmd[0] = W25Q128_CMD_SECTOR_ERASE;
    cmd[1] = (uint8_t)(addr >> 16U);
    cmd[2] = (uint8_t)(addr >> 8U);
    cmd[3] = (uint8_t)addr;

    w25q128_select();
    if (w25q128_tx(cmd, sizeof(cmd)) == 0U) {
        w25q128_deselect();
        return 0U;
    }
    w25q128_deselect();

    return w25q128_wait_ready(W25Q128_ERASE_TIMEOUT_MS);
}

static uint8_t w25q128_read_data(uint32_t addr, uint8_t *data, uint16_t len)
{
    uint8_t cmd[4];

    if ((data == NULL) || (len == 0U)) {
        return 0U;
    }

    cmd[0] = W25Q128_CMD_READ_DATA;
    cmd[1] = (uint8_t)(addr >> 16U);
    cmd[2] = (uint8_t)(addr >> 8U);
    cmd[3] = (uint8_t)addr;

    w25q128_select();
    if ((w25q128_tx(cmd, sizeof(cmd)) == 0U) || (w25q128_rx(data, len) == 0U)) {
        w25q128_deselect();
        return 0U;
    }
    w25q128_deselect();

    return 1U;
}

static uint8_t w25q128_page_program(uint32_t addr, const uint8_t *data,
                                    uint16_t len)
{
    uint8_t cmd[4];

    if ((data == NULL) || (len == 0U) || (len > 256U) ||
        (((addr & 0xFFU) + (uint32_t)len) > 256U)) {
        return 0U;
    }

    if (w25q128_write_enable() == 0U) {
        return 0U;
    }

    cmd[0] = W25Q128_CMD_PAGE_PROGRAM;
    cmd[1] = (uint8_t)(addr >> 16U);
    cmd[2] = (uint8_t)(addr >> 8U);
    cmd[3] = (uint8_t)addr;

    w25q128_select();
    if ((w25q128_tx(cmd, sizeof(cmd)) == 0U) || (w25q128_tx(data, len) == 0U)) {
        w25q128_deselect();
        return 0U;
    }
    w25q128_deselect();

    return w25q128_wait_ready(W25Q128_TIMEOUT_MS);
}

static uint8_t w25q128_read_magic(uint32_t slot, uint32_t *magic)
{
    uint32_t addr;

    if ((magic == NULL) || (slot >= W25Q128_TELEM_SLOTS)) {
        return 0U;
    }

    addr = W25Q128_TELEM_BASE_ADDR +
           (slot * W25Q128_TELEM_SLOT_SIZE) +
           (uint32_t)offsetof(W25Q128TelemetryRecord, magic);

    return w25q128_read_data(addr, (uint8_t *)magic, (uint16_t)sizeof(*magic));
}

static void w25q128_scan_slots(void)
{
    uint32_t slot;
    uint32_t magic;
    uint32_t first_erased = W25Q128_TELEM_SLOTS;
    uint32_t valid_count = 0U;

    write_slot = 0U;
    cache_full = 0U;

    for (slot = 0U; slot < W25Q128_TELEM_SLOTS; slot++) {
        if (w25q128_read_magic(slot, &magic) == 0U) {
            cache_full = 1U;
            printf("[W25Q128] slot scan failed at %u\n", (unsigned int)slot);
            return;
        }

        if (magic == W25Q128_RECORD_MAGIC) {
            valid_count++;
        } else if ((magic == W25Q128_ERASED_MAGIC) &&
                   (first_erased == W25Q128_TELEM_SLOTS)) {
            first_erased = slot;
        }
    }

    if (first_erased < W25Q128_TELEM_SLOTS) {
        write_slot = first_erased;
        return;
    }

    if (valid_count == 0U) {
        if (w25q128_sector_erase(W25Q128_TELEM_BASE_ADDR) != 0U) {
            write_slot = 0U;
            return;
        }
    }

    cache_full = 1U;
}
#endif

void W25Q128_Init(void)
{
#if W25Q128_USE_HAL_SPI
    uint8_t cmd = W25Q128_CMD_JEDEC_ID;
    uint8_t id[3] = {0};

    w25q128_deselect();
    w25q128_select();
    if ((w25q128_tx(&cmd, 1U) != 0U) && (w25q128_rx(id, sizeof(id)) != 0U)) {
        printf("[W25Q128] JEDEC ID: %02X %02X %02X\n", id[0], id[1], id[2]);
        w25q128_scan_slots();
        printf("[W25Q128] cache next slot=%u full=%u\n",
               (unsigned int)write_slot,
               (unsigned int)cache_full);
    } else {
        printf("[W25Q128] init failed (SPI1 PA4/PA5/PA6/PA7)\n");
    }
    w25q128_deselect();
#else
    printf("[W25Q128] init OK (stub fallback; enable SPI1 PA4/PA5/PA6/PA7 for real driver)\n");
#endif
}

uint8_t W25Q128_WriteTelemetry(const TelemetryData *telemetry)
{
    W25Q128TelemetryRecord record;
    uint32_t addr;

    if (telemetry == NULL) {
        return 0;
    }

    memset(&record, 0, sizeof(record));
    record.temperature_c = telemetry->env.temperature_c;
    record.humidity_percent = telemetry->env.humidity_percent;
    record.latitude = telemetry->gps.latitude;
    record.longitude = telemetry->gps.longitude;
    record.env_valid = telemetry->env.valid;
    record.gps_valid = telemetry->gps.valid;
    record.magic = W25Q128_RECORD_MAGIC;

    addr = W25Q128_TELEM_BASE_ADDR + (write_slot * W25Q128_TELEM_SLOT_SIZE);

#if W25Q128_USE_HAL_SPI
    uint8_t verify[sizeof(W25Q128TelemetryRecord)] = {0};
    uint32_t slot_magic = 0U;

    if (cache_full != 0U) {
        printf("[W25Q128] cache full, telemetry not cached\n");
        return 0U;
    }

    if ((w25q128_read_magic(write_slot, &slot_magic) == 0U) ||
        (slot_magic != W25Q128_ERASED_MAGIC)) {
        printf("[W25Q128] slot %u not erased, telemetry not cached\n",
               (unsigned int)write_slot);
        cache_full = 1U;
        return 0U;
    }

    if (w25q128_page_program(addr, (const uint8_t *)&record,
                             (uint16_t)sizeof(record)) == 0U) {
        printf("[W25Q128] cache telemetry failed at 0x%06X\n", (unsigned int)addr);
        return 0U;
    }

    if ((w25q128_read_data(addr, verify, (uint16_t)sizeof(verify)) == 0U) ||
        (memcmp(verify, &record, sizeof(record)) != 0)) {
        printf("[W25Q128] verify failed at 0x%06X\n", (unsigned int)addr);
        return 0U;
    }

    printf("[W25Q128] cached telemetry at 0x%06X\n", (unsigned int)addr);
    write_slot++;
    if (write_slot >= W25Q128_TELEM_SLOTS) {
        write_slot = 0U;
        cache_full = 1U;
    }
#else
    write_slot = (write_slot + 1U) % W25Q128_TELEM_SLOTS;
    printf("[W25Q128] cache telemetry stub slot=%u\n", (unsigned int)write_slot);
#endif
    return 1;
}

uint8_t W25Q128_FlushCache(void)
{
    uint8_t sent = 0;
    uint32_t slot;
    uint32_t addr;

    printf("[W25Q128] flushing cached telemetry...\n");

    for (slot = 0U; slot < W25Q128_TELEM_SLOTS; slot++) {
        W25Q128TelemetryRecord record;
        TelemetryData telemetry;

        addr = W25Q128_TELEM_BASE_ADDR + (slot * W25Q128_TELEM_SLOT_SIZE);

#if W25Q128_USE_HAL_SPI
        w25q128_read_data(addr, (uint8_t *)&record, (uint16_t)sizeof(record));

        if (record.magic != W25Q128_RECORD_MAGIC) {
            continue;
        }

        memset(&telemetry, 0, sizeof(telemetry));
        telemetry.env.temperature_c = record.temperature_c;
        telemetry.env.humidity_percent = record.humidity_percent;
        telemetry.gps.latitude = record.latitude;
        telemetry.gps.longitude = record.longitude;
        telemetry.env.valid = record.env_valid;
        telemetry.gps.valid = record.gps_valid;

        printf("[W25Q128] retransmit slot %u T=%.0f H=%.0f lat=%.0f lon=%.0f\n",
               (unsigned int)slot,
               (double)record.temperature_c, (double)record.humidity_percent,
               (double)record.latitude, (double)record.longitude);

        if (MQTT_PublishTelemetry(&telemetry) != 0U) {
            uint32_t clear_magic = 0U;
            uint32_t magic_addr = addr + (uint32_t)offsetof(W25Q128TelemetryRecord, magic);

            sent++;
            /* 清除 magic 标记已发送 */
            if (w25q128_page_program(magic_addr,
                                     (const uint8_t *)&clear_magic,
                                     (uint16_t)sizeof(clear_magic)) == 0U) {
                printf("[W25Q128] clear sent slot %u failed\n", (unsigned int)slot);
            }
        }
#else
        (void)addr;
        (void)telemetry;
#endif
    }

#if W25Q128_USE_HAL_SPI
    if (sent > 0U) {
        w25q128_scan_slots();
    }
#endif

    printf("[W25Q128] flush done: %u retransmitted\n", sent);
    return sent;
}

void W25Q128_Task(void)
{
    printf("[W25Q128] cache task idle\n");
}
