MashedPotato817/CargoTracker-STM32H7/(commit log)

2026-07-05 初始化文件
2026-07-05 添加test1
2026-07-05 更新 .gitignore：忽略 Keil MDK 编译产物及用户配置
    - 忽略 *.o *.axf *.hex *.map 等编译输出
    - 忽略 *.uvguix.* *.uvoptx 等用户专属配置
    - 忽略 .mxproject CubeMX 缓存
    - 忽略 Thumbs.db .DS_Store 等系统文件
2026-07-05 Revert "更新 .gitignore：忽略 Keil MDK 编译产物及用户配置"
    This reverts commit 4a59bbafe8cf506e0c00774df6aef95533f801da.
2026-07-05 从 git 跟踪中移除 test1/（保持本地文件）
    test1/ 已加入 .gitignore，但因之前已被提交到仓库而仍在跟踪中。
    使用 git rm --cached 取消跟踪，保留本地文件。
2026-07-05 初始化readme
2026-07-06 新建task分工
2026-07-06 添加接线和cube配置说明
2026-07-06 更新doc
2026-07-06 修改readme 新增用户手册的md格式
2026-07-06 更新文档，添加FreeRTOS任务架构和开发策略说明
2026-07-06 更新文档，完善任务开发计划和故障排查记录
2026-07-06 优化task1: 修正栈大小限制128Words，新增踩坑记录第6条，细化Step1为15步
2026-07-06 更新踩坑记录: 新增AC6+RVDS port不兼容问题及解决方案
    - 新增 TROUBLESHOOTING.md 第7条: ARM Compiler 6 与 FreeRTOS RVDS port 不兼容，
    需改用 GCC/ARM_CM7 port
    - .gitignore 添加 error1/ 目录
    - 保留 error1.md 编译错误日志作为参考
2026-07-06 更新踩坑记录：新增AC6+RVDS port不兼容问题及解决方案
2026-07-06 新增执行日志文档，记录FreeRTOS任务执行情况及关键修复记录
2026-07-06 提交test1
2026-07-07 第一次代码编写
2026-07-07 优化 .gitignore + 整理文档 + 建立 Git 协作规范 (#1)
    * 优化.gitignore，移除编译产物和库文件追踪
    - 新增 Keil 编译产物忽略规则（.o/.d/.axf/.hex/.map 等）
    - 新增用户私有文件忽略（*.uvguix.*, *.uvoptx）
    - 新增 CubeMX 生成文件忽略（*.mxproject, DebugConfig/, RTE/）
    - 移除 Drivers/ 和 Middlewares/ 追踪（CubeMX 生成，不入库）
    - 追踪文件从 1845 精简至 63 个（96.6%）
    * 整理文档，更新硬件到齐工作流，建立Git协作规范
    文档整理：
    - 归档6个历史日志 + 删除4个构建日志 → doc-workflow/archive/
    - CLAUDE.md: stub策略 → 条件编译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
2026-07-07 补充首次设置说明，消除库文件缺失的信息差
    CLAUDE.md: 新增「首次设置」章节，说明 Drivers/Middlewares 不在 Git 中，
    必须用 CubeMX 6.17.0 + FW_H7 V1.13.0 Generate Code
    README.md: 环境准备中明确 CubeMX 版本要求 + 首次克隆后设置步骤
    GIT_WORKFLOW.md: 新增首次设置章节 + 现有成员 pull 后的注意事项
2026-07-07 GIT_WORKFLOW: 补充防止误提交 Drivers/Middlewares 的说明
2026-07-07 更新 .gitignore，添加 test1.ioc、test1.uvprojx 和 system_stm32h7xx.c 文件以防止误提交
2026-07-07 取消追踪 .ioc/.uvprojx/system_stm32h7xx.c，全部由 CubeMX 生成
    这三个文件在多人 CubeMX 版本不同时会产生冲突。
    队友本地已有，通过 Generate Code 即可恢复。
    更新 .gitignore、CLAUDE.md 首次设置、GIT_WORKFLOW.md 首次设置。
2026-07-07 Revert "取消追踪 .ioc/.uvprojx/system_stm32h7xx.c，全部由 CubeMX 生成"
    This reverts commit c03c3e3fd6aff5fa4d03113cf450b60e839f228c.
2026-07-07 Revert "更新 .gitignore，添加 test1.ioc、test1.uvprojx 和 system_stm32h7xx.c 文件以防止误提交"
    This reverts commit 06566d3fa28c075efeeaf851af8f0ceca3aa45c7.
2026-07-07 Revert "GIT_WORKFLOW: 补充防止误提交 Drivers/Middlewares 的说明"
    This reverts commit 8175e64b8e569f6451870e74c474d44437029345.
2026-07-07 Revert "补充首次设置说明，消除库文件缺失的信息差"
    This reverts commit 65d272aaf2f8908548b3f2f09861ddd72ed24e0c.
2026-07-07 取消追踪 CubeMX 生成文件，全部由 Generate Code 恢复 (#2)
    * 补充首次设置说明，消除库文件缺失的信息差
    * GIT_WORKFLOW: 补充防止误提交 Drivers/Middlewares 的说明
    * 更新 .gitignore，添加 test1.ioc、test1.uvprojx 和 system_stm32h7xx.c 文件以防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
2026-07-07 Add I2C and SPI configurations, update GPIO settings, and enhance FreeRTOS task management
    - Introduced I2C1 configuration with fast speed and timing parameters.
    - Added SPI1 settings including baud rate, data size, and direction.
    - Updated GPIO settings for various pins including USART, I2C, and additional outputs.
    - Enhanced FreeRTOS task definitions and priorities.
    - Adjusted project settings in the .ioc file for better integration and functionality.
2026-07-07 docs: 新增 CubeMX 重新生成后必查清单 & current_status.md 忽略规则
2026-07-07 docs: 更新项目文档至 Task 2 代码完成状态
    - CLAUDE.md: PB0 冲突标注、补充 GPS/Air780E 驱动标志位、代码结构补 i2c/spi/usart、文件索引加
    current_status
    - GIT_WORKFLOW.md: 分支图更新（W 标记已合并，待验证分支列出）
    - task2.md: 前置条件打勾，2.1~2.6 逐项标注完成/阻塞状态
    - hardware_map.md: 外设表从待配置→代码就绪，CubeMX 状态表全勾，PB0 说明更正
    - .gitignore: 移除 current_status.md 排除规则（现在跟踪该文件）
2026-07-07 task2: CubeMX 重新生成后的全面修复 + PB0 切换为 Air780E PWRKEY
    - CubeMX: PB0 从 LD1_GREEN → AIR780E_PWRKEY，心跳保持 PE1
    - usart.c/h: 恢复 huart1/huart2 变量定义 + MX_USART1/2_UART_Init + MSP init/deinit
    - main.h: 补回 W25Q128_CS、BUZZER、ALARM_LED 引脚宏
    - gpio.c: 补回 GPIOA 时钟 + W25Q128_CS/Buzzer/LED 初始化
    - task2.md: Task 2.6 标记进行中，文件变更清单补状态列
    - 新增 logC-log4.md: 记录 W 分支合并 + CubeMX 修复全过程
    [main.h]
2026-07-08 新增硬件接线指南 index.html（GitHub Pages 移动端适配）
    覆盖内容：
    - 接线总览表（8 个模块）
    - 电源架构图（3.3V + 4.0V 独立供电）
    - 逐模块接线表（引脚 + 说明）
    - 排针焊接方向图解
    - MP1584 稳压模块接线
    - 推荐接线顺序 + 引脚速查卡
2026-07-08 更新 .gitignore 文件，移除 user-manual-pdf/ 目录；新增英文和中文用户手册 PDF 文件
2026-07-08 feat(i2c): add GPIO initialization for I2C1 and enhance PN532/SHT31 error handling
    [i2c.c, pn532.c, sht31.c]
2026-07-08 feat(i2c): enhance error logging for PN532 and SHT31 initialization with GPIO state
    [i2c.c, pn532.c, sht31.c]
2026-07-08 feat(i2c): add I2C1_DebugScan function and integrate it into SHT31 initialization error handling
    [i2c.c, sht31.c]
2026-07-08 feat(pn532): integrate I2C1_DebugScan into PN532 initialization error handling
    [pn532.c]
2026-07-08 docs: 新增 Task 3-5 计划 + EMQX 指南 + 设计报告 + 更新 README
    - task3.md: 云平台对接（🔴必做 🟡加分标注）
    - task3.1.md: EMQX Cloud 注册 5 步指南（30min 可完成）
    - task4.md: 低功耗优化计划
    - task5.md: 整机测试 + 产出物计划
    - report-workflow/design_report.md: 设计文档 8 章框架
    - README.md: 更新项目结构
    - TROUBLESHOOTING.md: 新增 #13 CubeMX Gen Code 三步修复
2026-07-08 feat(mqtt): implement binary MQTT stack over TCP AT commands
    Replace AT-based CMQTT with raw TCP MQTT 3.1.1 implementation:
    - Rename MQTT_SendAT to TCP_SendAT with configurable timeout
    - Add MQTT broker config (broker.emqx.io:1883, topics, client ID)
    - Add binary MQTT packet builders: CONNECT, PUBLISH (QoS 0)
    - Add TCP_SendBinary via AT+CIPSEND for raw packet delivery
    - Rewrite MQTT_Init to use CIPSTART + MQTT CONNECT handshake
    - Rewrite MQTT_PublishTelemetry to use binary PUBLISH packets
    - Increase buffer sizes: PAYLOAD 128→256, RX 160→512
    [mqtt.c]
2026-07-08 feat(app): add debug logging and auto-start workaround for PC13 button fault
    - Add startup debug printf to trace StateMachine_Init, Alarm_Init, Power_Init
    - Add auto NFC activation trigger to bypass PC13 button hardware fault
    - Add debug printf for I2C sensor task init sequence
    [app.c]
2026-07-08 feat(doc): 添加 EMQX Cloud 部署配置日志
2026-07-08 fix: hardware bringup fixes — Air780E power, buzzer, CONNACK, GPIO init
    - power: add Power_Air780E_PowerOn/PowerOff (VBAT auto-start, PWRKEY 1.5s shutdown)
    - gpio: PWRKEY default HIGH (was RESET causing unwanted power-off)
    - mqtt: drain CONNACK response after CONNECT to avoid corrupting CIPSEND
    - alarm: buzzer control on PC8 (LOW=active, HIGH=off per 3.3V-buzzer-PC8 wiring)
    - app: add 5s startup delay for Air780E VBAT stabilization
    - air780e: use Power_Air780E_PowerOn() instead of stale PWRKEY note
    [air780e.c, alarm.c, app.c, mqtt.c, power.c]
2026-07-08 feat: 新增 Web 云端控制台 dashboard.html (#3)
    自建单文件 MQTT 控制台，直连 broker.emqx.io：
    - 实时温湿度/GPS/电池显示
    - 三指令按钮（暂留/退货/继续运输）
    - 数据日志滚动显示
    - GitHub Pages 部署，手机可达
    更新文档：
    - README.md: 添加 dashboard.html 到项目结构
    - task3.1.md: 更新云端查看方案（自建控制台）
    - log3.1.md: 补充 TCP/TLS 双方案 + 云端监控方案
2026-07-08 docs: 添加竞赛作品上传要求与报告模板
    - demand.md: 嵌入式芯片大赛上传要求（截止 7月9日18:00）
    - template.md: 官方报告模板（5章结构）
2026-07-08 fix: resolve PB0 conflict with Air780E PWRKEY and update related documentation
    [app.c, power.c]
2026-07-08 fix(air780e): 增加模块启动等待时间
    - Air780E_Init: PowerOn 后增加 HAL_Delay(5000) 等待模块启动
    - App_TaskStateMachine: 启动延迟从 5s 延长到 10s，确保模块稳定就绪
    [air780e.c, app.c]
2026-07-08 Revert "Merge branch 'main' of https://github.com/MashedPotato817/CargoTracker-STM32H7"
    This reverts commit 62fd3ff83dbb9e63cc3fee8c1edf8060e005e8f0, reversing
    changes made to df064033b899541bc203bced47fc177d9cbc957f.
    [air780e.c, app.c]
2026-07-08 feat: 添加基于STM32H7的智能货物追踪物联网系统报告文档
2026-07-08 feat(power): enhance Air780E power management with delays and logging
2026-07-08 fix(dashboard): 兼容 gps_valid 字段名，修复GPS有效状态显示
    设备发送 gps_valid:1，dashboard 此前只识别 gps_v
2026-07-08 fix(dashboard): 电池区替换为信号强度 + 最后上报计时
    - 替换电池区为 CSQ 信号强度显示（设备需在JSON中加 csq 字段）
    - 新增「最后上报」计时器，2秒刷新
    - 颜色标注：≥20绿 ≥10黄 <10红
2026-07-08 fix: 硬件调通收尾修复
    - air780e: AT 超时不阻塞初始化，以网络注册状态为准
    - mqtt: 订阅主题 cargo/command → cargo/cmd 缩短
    - gpio: 蜂鸣器初始化独立设 HIGH（关），避免上电误响
    [air780e.c, mqtt.c]
2026-07-08 docs: 添加 Task 2 硬件集成执行日志
    记录 SHT31/PN532/GPS/W25Q128/Air780E/MQTT/蜂鸣器 验证结果及 5 项关键修复
2026-07-08 docs: 更新 task2 至实际硬件验证状态（基于串口数据）
    - Task 2.2: SHT31 ✅ 真实数据(24-25°C/47-51%) Pn532 ⚠️ 待标签测试
    - Task 2.3: GPS ⚠️ stub(lat=31/lon=121) 待户外测试
    - Task 2.4: W25Q128 JEDEC EF4018 ✅
    - Task 2.5: Air780E AT/MQTT 全链路 ✅ CSQ=27~28
    - Task 2.6: PB0 已完成 ✅
2026-07-08 docs: 新增 task3.3 真 MQTT 云指令接收方案
    B 组任务：替换 mqtt.c 中 MQTT_PollCommand() 的 stub 循环为
    真 MQTT SUBSCRIBE + PUBLISH 解析，实现 dashboard → broker → 设备指令链路
2026-07-08 feat(mqtt): 添加 SUBSCRIBE 订阅 + CIPRXGET 真实接收
    - MQTT_Init: CONNACK 后发送 SUBSCRIBE 包订阅 cargo/cmd
    - MQTT_PollCommand: 用 AT+CIPRXGET=2 查询 TCP 缓冲区接收云端指令
    - CIPRXGET 不支持时自动降级到 stub 轮转模式
2026-07-08 docs: 更新竞赛报告第三部分 — 填入真实串口测试数据
    - Air780E AT 指令序列实测 (CSQ=27~28, CREG/CGREG/CEREG/GGATT 全OK)
    - MQTT CONNECT/PUBLISH 实测
    - SHT31 实测温湿度 (24-25°C, 47-51%)
    - W25Q128 JEDEC EF4018 实测
    - 系统启动日志
2026-07-08 feat: 竞赛报告 HTML 版 — GitHub Pages 在线阅读
    单文件 HTML，暗色主题，移动端适配，五章完整内容 + 真实串口数据
2026-07-08 fix(dashboard): MQTT 断线自动重连 + task3.3/log3.3 文档更新
    - dashboard.html: 新增 reconnectPeriod(3s)/connectTimeout(10s)/reconnect 事件
    - 断线→重连中→已连接 状态全程可视化
    - task3.3.md: 新增前端控制台章节、端到端验证步骤
    - log3.3.md: 综合执行日志（B 后端 MQTT 指令 + C 前端重连）
    - opt3.3.md: 早期规划草稿，标记过期
2026-07-09 docs(task5): 移除 PPT，产出物对齐竞赛 demand.md
    - 删除 Task 5.4 答辩 PPT（竞赛不要求）
    - 原 Task 5.5 视频 → Task 5.4，补充格式/大小/封面要求
    - 新增 Task 5.5 代码打包 RAR（≤100MB）
    - 补充截止时间 7/9 18:00 + 匿名要求
    - Part B 产出物完全对应 demand.md 三件套
2026-07-09 feat(dashboard): Leaflet 地图实时定位 + 华东范围锁定
    - 新增 Leaflet.js + CartoDB Dark Matter 暗色地图
    - GPS 数字卡片替换为实时地图卡片
    - 范围限定华东（[[27,116],[35.5,123]]），默认长三角居中
    - 首次定位自动飞行到设备位置(zoom 15)，后续 marker 平滑跟踪
    - gps_valid=0 时 marker 变灰
    - 修复瓦片闪烁：fadeAnimation:false + updateWhenIdle:false
    - task3.5.md: 地图实现方案文档
    - task3.md: 新增 Task 3.5 条目
2026-07-09 docs(log3.5): 地图实时定位执行日志
    - 方案选型记录（Leaflet vs 高德/百度）
    - 地图配置参数说明
    - 暗色适配 + 闪烁修复
2026-07-09 feat: NFC 拨动开关 + 定时上报 + 报警防抖
    状态机重构：
    - NFC 刷卡：系统激活、Air780E 开机、LD2 心跳开始
    - 再次刷卡：Air780E 关机、LED/蜂鸣器全关、休眠
    - 在线期间每 10 秒自动 GPS+SHT31+MQTT 上报
    - GPS/SHT31 采样循环中实时响应 NFC 关机
    报警防抖：
    - Alarm_CheckEnv → Alarm_FeedSample，连续 2 次超阈值才触发
    - 连续归零才解除，防误报
    - Alarm_SetSystemActive 控制休眠时 LED/蜂鸣器全关
    Air780E 初始化：
    - PowerOn 调用移至状态机 NFC 激活时
    - App_Task4GMQTT 不再主动初始化模块
2026-07-09 fix(dashboard): 优化地图瓦片显示并更新 task3.5 文档
2026-07-09 fix(gps): 默认坐标清零 + 循环查找有效 NMEA 句
    - last_location 初始值改为 0,0, valid=0，不再用上海假坐标
    - GPS_GetLocation 循环最多 10 次跳过非 RMC/GGA 的行
    [gps.c]
2026-07-09 fix(mqtt): 保留 GPS 和环境数据的小数位，修正 MQTT 上报格式
    [app.c, mqtt.c]
2026-07-09 fix(mqtt): improve binary transmission confirmation and error handling
    [mqtt.c]
2026-07-09 docs: 代码全面审查报告（7 致命 + 12 警告 + 10 建议）
    - 3 组并行审计 11 个 C 文件（驱动层/通信层/应用层）
    - 🔴 致命：USART1 竞态/FIFO溢出、TCP_SendBinary假成功、CONNACK未检查、
    W25Q128重启擦除/上传路径缺失、printf无互斥
    - 🟡 警告：HAL_Delay忙等待5处、I2C1无互斥、PN532越界/DCS、
    GPS空字段/strtok/精度、MQTT命令误触发等
    - 🟢 建议：死代码、STATE_WAIT_CLOUD未使用、AT重试等
    - P0-P3 优先级修复建议
2026-07-09 docs: 整理 doc-workflow 目录结构
    - 根目录 27→13 文件，只保留活跃文档
    - archive/logs/: 全部执行日志 (15 个)
    - archive/plans/: 过期计划 (opt3.3, task1, proposal)
    - archive/debug/: 调试产物 (error1, PortReceive, 7 个 keil log)
    - 新增 README.md: 目录使用指南
    - 新增 last-tasks.md: 当前未完成任务入口
2026-07-09 feat: Flash 缓存补发 + 真实 Sleep 模式 + NFC 轮询优化
    - w25q128: 新增 FlushCache，联网后遍历 Flash 槽位补发缓存数据
    - power: Power_EnterStopStub 改用 HAL_PWR_EnterSLEEPMode(WFI) 真实休眠
    - app: MQTT 初始化后调用 FlushCache 补发断网缓存
    - app: NFC 关机检测超时 0→200ms，避免空轮询占满 CPU
2026-07-09 fix(dashboard): 修复移动端地图不显示问题
    - Leaflet CDN 双源降级（unpkg → jsdelivr）
    - L 未定义时安全退出 + 友好提示
    - 页面加载后 invalidateSize 强制重算容器尺寸
    - 横竖屏切换时重算地图
    - tileerror 事件降级渐变背景
2026-07-09 fix(mqtt): 解析 SEND OK 确认 + 检测发送错误
    - TCP_SendBinary 改为实际读取模块返回，匹配 SEND OK
    - 检测 ERROR/FAIL/CLOSED 并返回失败
    - 超时从 5s 缩短到 1s (MQTT_SEND_CONFIRM_MS)
    [mqtt.c]
2026-07-09 fix(gps): 减少 NMEA 读取次数 + 立即返回定位
    - 循环 10→3 次，有数据立即返回不等完
    - 减少 GPS 采集阻塞时间
    [gps.c]
2026-07-09 feat(alarm): implement LED modes and buzzer control for cloud commands; fix GPS coordinate parsing
    [alarm.c, app.c, gps.c]
2026-07-09 fix: 遥测添加 CSQ + PDP 激活 + 上报周期优化
    - air780e: 新增 Air780E_SignalQuality() 获取 CSQ
    - mqtt: 遥测 JSON 增加 csq 字段；MQTT_Init 前激活 PDP + CIPSHUT 清旧连接
    - app: 云指令等待 30s→2s（后台轮询）；上报间隔 10s→5s
    [air780e.c, app.c, mqtt.c]
2026-07-09 docs: 三页面统一 footer + 跟踪 B 最新改动
    - index/dashboard/report 尾部统一跳转链接（接线·控制台·报告·GitHub）
    - last-tasks: B CSQ 已修、PDP 优化、C 前端完成项
    - 不动任何功能代码，纯美化 + 文档
2026-07-09 docs(design_report): 更新为实际状态 + GPT 绘图结构
    - §4 MQTT: 替换阿里云 IoT 模板为实际 cargo/telemetry + cargo/cmd
    - §4 JSON: 更新为实际精简格式 (72 bytes, csq 字段)
    - §5 云端: 补完数据流 + 前后端架构图结构（GPT 可画）
    - §6 低功耗: 标注实现状态
    - §8 测试: 填入实测数据 + 系统框图/软件架构图结构
2026-07-09 docs(design_report): 竞赛标准优化 — 表格化+可视化+理论→实测闭环
    - §3.4 状态机: ASCII流程图 + 8状态表(LED/动作/超时)
    - §3.6 驱动: 6行文字→1张对比表
    - §8 测试: 新增理论→实测闭环列, 7张实物照片清单
    - §8.3 MQTT时序图(GPT可画)
    - §9 GPT绘图清单: 6张图+7张照片汇总
2026-07-09 docs: GPT 绘图 prompts — 6张图+2条润色+使用流程
    - Prompt 1-6: 硬件框图/软件架构/状态机/MQTT时序/前后端/电源树
    - 报告润色: 摘要优化 + 创新点总结
    - 使用流程: 拍照→绘图→嵌入→导出PDF→打包
2026-07-09 docs: 演示视频录制与剪辑指南
    - 3分钟拍摄脚本（分9段，精确到秒）
    - 道具清单 + 工具推荐（OBS/剪映）
    - 双画面画中画技巧
    - 匿名检查清单
2026-07-09 docs: 更新 README + CLAUDE.md 反映当前项目状态
    - README: 新文件结构 + 竞赛交付阶段 + 模块状态表
    - CLAUDE: 文件索引补全（code-review/gpt-prompts/video-guide 等）
    - 当前阶段: 硬件集成→竞赛交付
2026-07-09 docs(CLAUDE): 新增编码规范自动触发 karpathy-guidelines skill
    - 顶部新增「编码规范」章节
    - 修改 .c/.h/.js/.html 前必须调用 karpathy-guidelines
    - PREFERENCES.md 同步更新：必须→强调
2026-07-09 docs: 添加 C组应用集成开发日志 6，记录云端指令声光动作异步化问题及修复
    [app.c, gps.c]
2026-07-09 docs: 更新 .gitignore，添加 video/ 目录以排除项目特定文件
2026-07-09 docs: 硬件实物照片 — 通信天线/GPS天线/总览
    - AIR780通信天线.png
    - GPS天线.png
    - 硬件总览图.png
2026-07-09 feat: Enhance code stability and performance across multiple modules
    - Added mutex handling in MQTT for thread safety during UART operations.
    - Updated power management functions to use osDelay instead of HAL_Delay for better RTOS compatibility.
    - Improved W25Q128 flash memory handling with status checks and cache management.
    - Enhanced GPS module to dynamically adjust baud rate and improve NMEA sentence processing.
    - Refined PN532 NFC communication with better response validation.
    - Updated sensor SHT31 to utilize osDelay for non-blocking delays.
    [gps.c, mqtt.c, pn532.c, power.c, sht31.c, w25q128.c]
2026-07-09 docs(video): 演示视频分段解说文案
    - 8段完整文案（片头→NFC→GPS→SHT31→4G→云指令→休眠→全链路）
    - 每段含画面描述+字幕+配音
    - 匿名检查提示
    - 双画面画中画标注
2026-07-09 docs: 补充图片 — 云端控制台截图 + 大赛封面
    - CargoTracker 云端控制台（3张截图）
    - 大赛统一封面
