MashedPotato817/CargoTracker-STM32H7/(notices)

Notices in the files:
test1/Core/Inc/main.h:
Copyright (c) 2026 STMicroelectronics.
All rights reserved.
This software is licensed under terms that can be found in the LICENSE file
